mincrmatt12/MWatch/board/bigboard/bom.ods

Source: | /home/matthew/MWatch/board/bigboard/bigboard.kicad_sch
Date: | Thu 16 Jun 2022 10:04:57 PM
Tool: | Eeschema 6.0.5-a6ca702e91~116~ubuntu20.04.1
Generator: | /usr/share/kicad/plugins/bom_csv_grouped_by_value.py
Component Count: | 143
Item | Qty | Reference(s) | Value | LibPart | Footprint | Description | MPN | Type | Notes
1 | 2 | AE1, AE2 | Antenna_Loop | Device:Antenna_Loop | TerminalBlock_TE-Connectivity:TerminalBlock_TE_282834-2_1x02_P2.54mm_Horizontal | TERM BLK 2P SIDE ENT 2.54MM |  | DNP (TH)
2 | 1 | BT1 | Battery_Cell | Device:Battery_Cell | Connector_JST:JST_PH_B3B-PH-K_1x03_P2.00mm_Vertical | CONN HEADER VERT 3POS 2MM | B3B-PH-K-S(LF)(SN) | DNP (TH)
3 | 2 | C1, C4 | 470nF | Device:C | Capacitor_SMD:C_0402_1005Metric | CAP CERM 470nF +/- 10% 50V X5R 0402 |  | SMD
4 | 1 | C2 | 0.082uF | Device:C | Capacitor_SMD:C_0402_1005Metric | CAP CERM 0.082uF +/- 10% 50V X7R 0402 |  | SMD
5 | 1 | C3 | 0.22uF | Device:C | Capacitor_SMD:C_0402_1005Metric | CAP CERM 0.22uF +/- 10% 50V X7R 0402 |  | SMD
6 | 1 | C5 | 360pF | Device:C | Capacitor_SMD:C_0402_1005Metric | CAP CERM 360pF +/- 5% 50V C0G/NP0 0402 |  | SMD
7 | 2 | C6, C7 | 0.068uF | Device:C | Capacitor_SMD:C_0402_1005Metric | CAP CERM 0.068uF +/- 10% 25V X7R 0402 |  | SMD
8 | 1 | C8 | 2700pF | Device:C | Capacitor_SMD:C_0402_1005Metric | CAP CERM 2700pF +/- 10% 50V X7R 0402 |  | SMD
9 | 2 | C9, C10 | 15nF | Device:C | Capacitor_SMD:C_0402_1005Metric | CAP CERM 15nF +/- 10% 25V X7R 0402 |  | SMD
10 | 28 | C11, C13, C18, C20, C22, C23, C24, C27, C32, C35, C36, C38, C39, C40, C41, C42, C43, C44, C45, C48, C49, C50, C51, C52, C54, C55, C58, C59 | 100nF | Device:C | Capacitor_SMD:C_0201_0603Metric | CAP CERM 100nF +/- 10% 25V X5R 0201 |  | SMD
11 | 10 | C12, C14, C17, C19, C21, C28, C37, C46, C47, C53 | 1uF | Device:C | Capacitor_SMD:C_0201_0603Metric | CAP CERM 1uF +/- 10% 25V X5R 0201 |  | SMD
12 | 7 | C15, C16, C25, C26, C29, C30, C31 | 10uF | Device:C | Capacitor_SMD:C_0603_1608Metric | CAP CERM 10uF +/10% 25V X5R 0603 |  | SMD
13 | 2 | C33, C34 | 27pF | Device:C | Capacitor_SMD:C_0201_0603Metric | CAP CERM 27pF +/- 5% 50V C0G/NP0 0201 |  | SMD
14 | 2 | C56, C57 | 120pF | Device:C | Capacitor_SMD:C_0201_0603Metric | CAP CERM 120pF +/- 5% 50V C0G/NP0 0201 |  | SMD
15 | 1 | D1 | SP0502BAHTG | Power_Protection:SP0502BAHT | Package_TO_SOT_SMD:SOT-23 | DIODE TVS 5.5VWM 8.5VC SOT23-3 | SP0502BAHTG | SMD | or equivalent
16 | 4 | D2, D3, D7, D8 | D | Device:D | Diode_SMD:D_SOD-323 | DIODE SCHOTTKY 30V 1A USC | CUS10S30,H3F | SMD
17 | 3 | D4, D5, D6 | LED | Device:LED | LED_SMD:LED_0603_1608Metric | LED WHITE CLEAR CHIP SMD 5mA 3.2V 0603 | BZ-C0603-C2-E1 | SMD
18 | 2 | J1, J2 | Conn_02x02_Row_Letter_First | Connector_Generic:Conn_02x02_Odd_Even | Connector_PinHeader_2.54mm:PinHeader_2x02_P2.54mm_Vertical | CONN HEADER VERT 2x02POS 2.54MM |  | DNP (TH)
19 | 1 | J3 | USB_C_Receptacle_USB2.0 | Connector:USB_C_Receptacle_USB2.0 | Connector_USB:USB_C_Receptacle_XKB_U262-16XN-4BVC11 | CONN RCP USB3.1 TYPEC SMD RA | U262-161N-4BVC11 | SMD
20 | 5 | J4, J5, J6, J7, J12 | Conn_01x03_Male | Connector:Conn_01x03_Male | Connector_PinHeader_2.54mm:PinHeader_1x03_P2.54mm_Vertical | CONN HEADER VERT 3POS 2.54MM |  | DNP (TH)
21 | 1 | J8 | Conn_2Rows-21Pins_MountingPin | Connector_Generic_MountingPin:Conn_2Rows-21Pins_MountingPin | displaymolex:5035662102 | CONN FPC BOTTOM 21POS 0.30MM | 503566-2102 | SMD
22 | 1 | J9 | Conn_01x05_Male | Connector:Conn_01x05_Male | Connector_PinHeader_2.54mm:PinHeader_1x05_P2.54mm_Vertical | CONN HEADER VERT 5POS 2.54MM |  | DNP (TH)
23 | 1 | J10 | Conn_02x03_Row_Letter_First | Connector_Generic:Conn_02x03_Odd_Even | Connector_PinHeader_2.54mm:PinHeader_2x03_P2.54mm_Vertical | CONN HEADER VERT 2x03POS 2.54MM |  | DNP (TH)
24 | 1 | J11 | Conn_01x02_Male | Connector:Conn_01x02_Male | Connector_PinHeader_2.54mm:PinHeader_1x02_P2.54mm_Vertical | CONN HEADER VERT 2POS 2.54MM |  | DNP (TH)
25 | 1 | J13 | Conn_02x07_Row_Letter_First | Connector_Generic:Conn_02x07_Odd_Even | Connector_PinHeader_2.54mm:PinHeader_2x07_P2.54mm_Vertical | CONN HEADER VERT 2x07POS 2.54MM |  | DNP (TH)
26 | 1 | L1 | 4.7uH | Device:L | Inductor_SMD:L_0805_2012Metric | INDUCTOR 4.7uH +/- 20% 600mA 400 mOHM 0805 | MLP2012V4R7MT0S1 | SMD | or equivalent
27 | 2 | L2, L3 | 2.2uH | Device:L | Inductor_SMD:L_0805_2012Metric | INDUCTOR 2.2uH +/- 20% 1.2A 228 mOHM 0805 | DFE201210U-2R2M=P2 | SMD | or equivalent
28 | 1 | M1 | Motor_AC | Motor:Motor_AC | TerminalBlock_TE-Connectivity:TerminalBlock_TE_282834-2_1x02_P2.54mm_Horizontal | TERM BLK 2P SIDE ENT 2.54MM |  | DNP (TH)
29 | 1 | Q1 | Q_Dual_PMOS_G1S2G2D2S1D1 | Device:Q_Dual_PMOS_G1S2G2D2S1D1 | Package_TO_SOT_SMD:SOT-23-6 | MOSFET 2P-CH 20V 2A SOT-26 | DMP2240UDM | SMD
30 | 9 | R1, R2, R3, R22, R23, R24, R25, R26, R27 | 10k | Device:R_US | Resistor_SMD:R_0201_0603Metric | RES SMD 10KOHM 1% 1/20W 0201 |  | SMD
31 | 2 | R4, R5 | 5.1k | Device:R_US | Resistor_SMD:R_0201_0603Metric | RES SMD 5.1KOHM 1% 1/20W 0201 |  | SMD
32 | 2 | R6, R8 | 102k | Device:R_US | Resistor_SMD:R_0201_0603Metric | RES SMD 102KOHM 1% 1/20W 0201 |  | SMD
33 | 2 | R7, R9 | 11.3k | Device:R_US | Resistor_SMD:R_0201_0603Metric | RES SMD 11.3KOHM 1% 1/20W 0201 |  | SMD
34 | 1 | R10 | 150 | Device:R_US | Resistor_SMD:R_0201_0603Metric | RES SMD 150OHM 1% 1/20W 0201 |  | SMD
35 | 1 | R11 | 2.2k | Device:R_US | Resistor_SMD:R_0201_0603Metric | RES SMD 2.2KOHM 1% 1/20W 0201 |  | SMD
36 | 1 | R12 | 3.3k | Device:R_US | Resistor_SMD:R_0201_0603Metric | RES SMD 3.3KOHM 1% 1/20W 0201 |  | SMD
37 | 1 | R13 | 470 | Device:R_US | Resistor_SMD:R_0201_0603Metric | RES SMD 470OHM 1% 1/20W 0201 |  | SMD
38 | 1 | R14 | 22 | Device:R_US | Resistor_SMD:R_0201_0603Metric | RES SMD 22OHM 1% 1/20W 0201 |  | SMD
39 | 1 | R15 | 20k | Device:R_US | Resistor_SMD:R_0201_0603Metric | RES SMD 20KOHM 1% 1/20W 0201 |  | SMD
40 | 1 | R16 | 1M | Device:R_US | Resistor_SMD:R_0201_0603Metric | RES SMD 1M0OHM 1% 1/20W 0201 |  | SMD
41 | 1 | R17 | 4k | Device:R_US | Resistor_SMD:R_0201_0603Metric | RES SMD 4KOHM 1% 1/20W 0201 |  | SMD
42 | 2 | R18, R19 | 1k | Device:R_US | Resistor_SMD:R_0201_0603Metric | RES SMD 1KOHM 1% 1/20W 0201 |  | SMD
43 | 2 | R20, R21 | 27 | Device:R_US | Resistor_SMD:R_0201_0603Metric | RES SMD 27OHM 1% 1/20W 0201 |  | SMD
44 | 8 | SW1, SW2, SW3, SW4, SW5, SW6, SW7, SW8 | SW_Push | Switch:SW_Push | Button_Switch_THT:SW_PUSH_6mm | SWITCH TACTILE SPST-NO 0.05A 24V | B3F-1020 | DNP (TH)
45 | 1 | TH1 | NTCG103JF103FT1 | Device:Thermistor_NTC_US | Resistor_SMD:R_0402_1005Metric | THERMISTOR NTC 10KOHM 3380K 0402 | NTCG103JF103FT1 | SMD | or equivalent
46 | 5 | TP1, TP2, TP3, TP4, TP5 | TestPoint | Connector:TestPoint | TestPoint:TestPoint_Pad_D2.5mm |  |  | n/a
47 | 1 | U1 | BQ51221YFPT | bq51020:BQ51221YFPT | bq51020:BQ51221YFPT | IC WIRELESS PWR RCVR 42DSBGA | BQ51221YFPT | SMD
48 | 1 | U2 | MAX20353AEWN+ | max20353:MAX20353AEWN+ | max20353:MAX20353AEWN&plus_ | IC WEARABLE PMIC | MAX20353AEWN+ | SMD
49 | 1 | U3 | D52MxxM8 | RF_Module:D52MxxM8 | RF_Module:Garmin_M8-35_9.8x14.0mm_Layout6x6_P1.5mm | BLUETOOTH MOD ISM>1GHZ TRC ANT SMD | D52MD2M8IA-TRAY | SMD
50 | 1 | U4 | RP2040 | rp2040:RP2040 | rp2040:RP2040-QFN-56 | IC RP2040 DUAL CORE MCU 56-QFN | SC0914(7) | SMD | also known as RP2040 at LCSC
51 | 2 | U5, U6 | SN74LVC8T245PWR | Logic_LevelTranslator:SN74AVC8T245PW | Package_SO:TSSOP-24_4.4x7.8mm_P0.65mm | IC 8-BIT DUAL-SUPPLY BUS TRANSCEIVER | SN74LVC8T245PWR | SMD | acceptable substitute is SN74LXC8T245PWR, SN74LVCH8T245PWR; -PW and -PWR parts are interchangable
52 | 1 | U7 | GD25LQ128DSIGR | Memory_Flash:W25Q128JVS | Package_SO:SOIC-8_5.23x5.23mm_P1.27mm | IC FLASH 128MBIT SPI/QUAD 8SOP 1.8V | GD25LQ128DSIGR | SMD | acceptable substitute is W25Q128JWS
53 | 1 | U8 | BMM150 | Sensor_Magnetic:BMM150 | Package_CSP:WLCSP-12_1.56x1.56mm_P0.4mm | SENSOR FLIPCORE/HALL I2C/SPI 12WLCSP | BMM150 | SMD
54 | 1 | U9 | BMI270 | Sensor_Motion:BMI160 | Package_LGA:Bosch_LGA-14_3x2.5mm_P0.5mm | SENSOR IMU ACCEL/GYRO I2C/SPI 14LGA | BMI270 | SMD
55 | 1 | U10 | APDS-9306-065 | Sensor_Optical:APDS-9306-065 | OptoDevice:Broadcom_DFN-6_2x2mm_P0.65mm | SENSOR AMBIENT LIGHT 6-DFN | APDS-9306-065 | SMD
56 | 1 | U11 | TXB0104D | Logic_LevelTranslator:TXB0104D | Package_SO:SOIC-14_3.9x8.7mm_P1.27mm | IC TRNSLTR BIDIRECTIONAL 14SOIC | TXB0104D | SMD
57 | 1 | U12 | PCF85263AT/AJ | Timer_RTC:PCF85263AT | Package_SO:SOIC-8_3.9x4.9mm_P1.27mm | IC RTC CLK/CALENDAR I2C 8SO | PCF85263AT/AJ | SMD | acceptable substitute is BQ32002DR
58 | 1 | Y1 | 12MHz | Device:Crystal | Crystal:Crystal_SMD_5032-2Pin_5.0x3.2mm | CRYSTAL 12.0000MHZ 18pF 50OHM 20 PPM SMD | 445C25D12M00000 | SMD | or equivalent
59 | 1 | Y2 | 32.768kHz | Device:Crystal | Crystal:Crystal_SMD_3215-2Pin_3.2x1.5mm | CRYSTAL 32.768KHZ 7pF 70KOHM 20 PPM SMD | SC32S-7PF20PPM | SMD | or equivalent
