mincrmatt12/MWatch/board/bigboard/bigboard.pdf

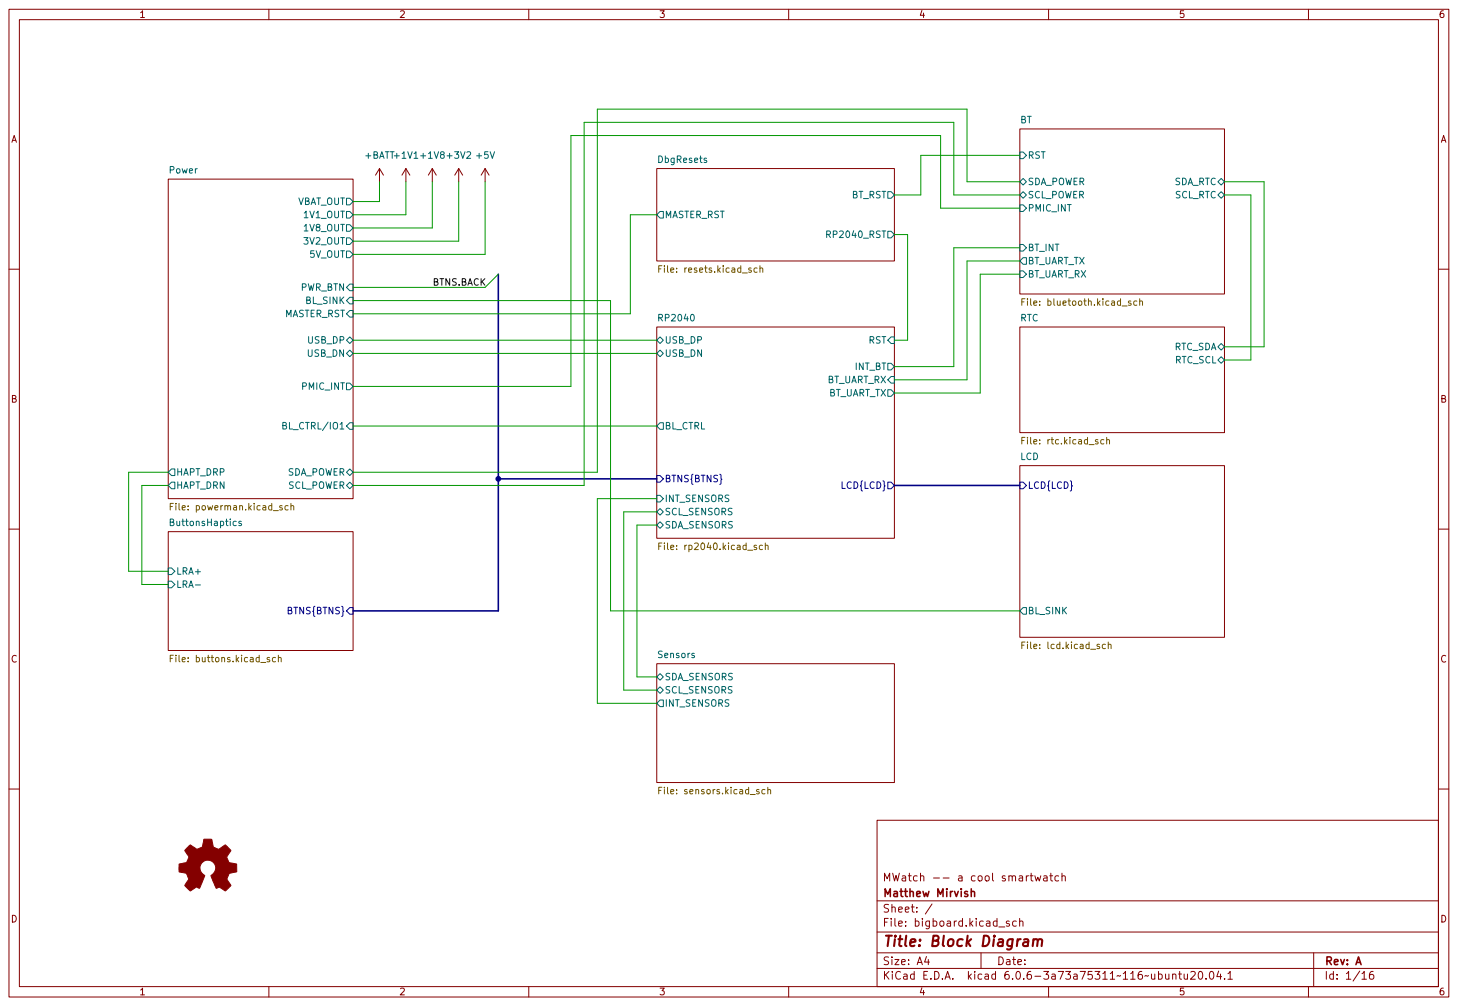
[picture p1: page 1]

File: lcd.kicad_sch BTNS{BTNS} LRA+

File: bigboard.kicad_sch Sheet: / Matthew Mirvish MWatch -- a cool smartwatch

Id: 1/16 Title: Block Diagram

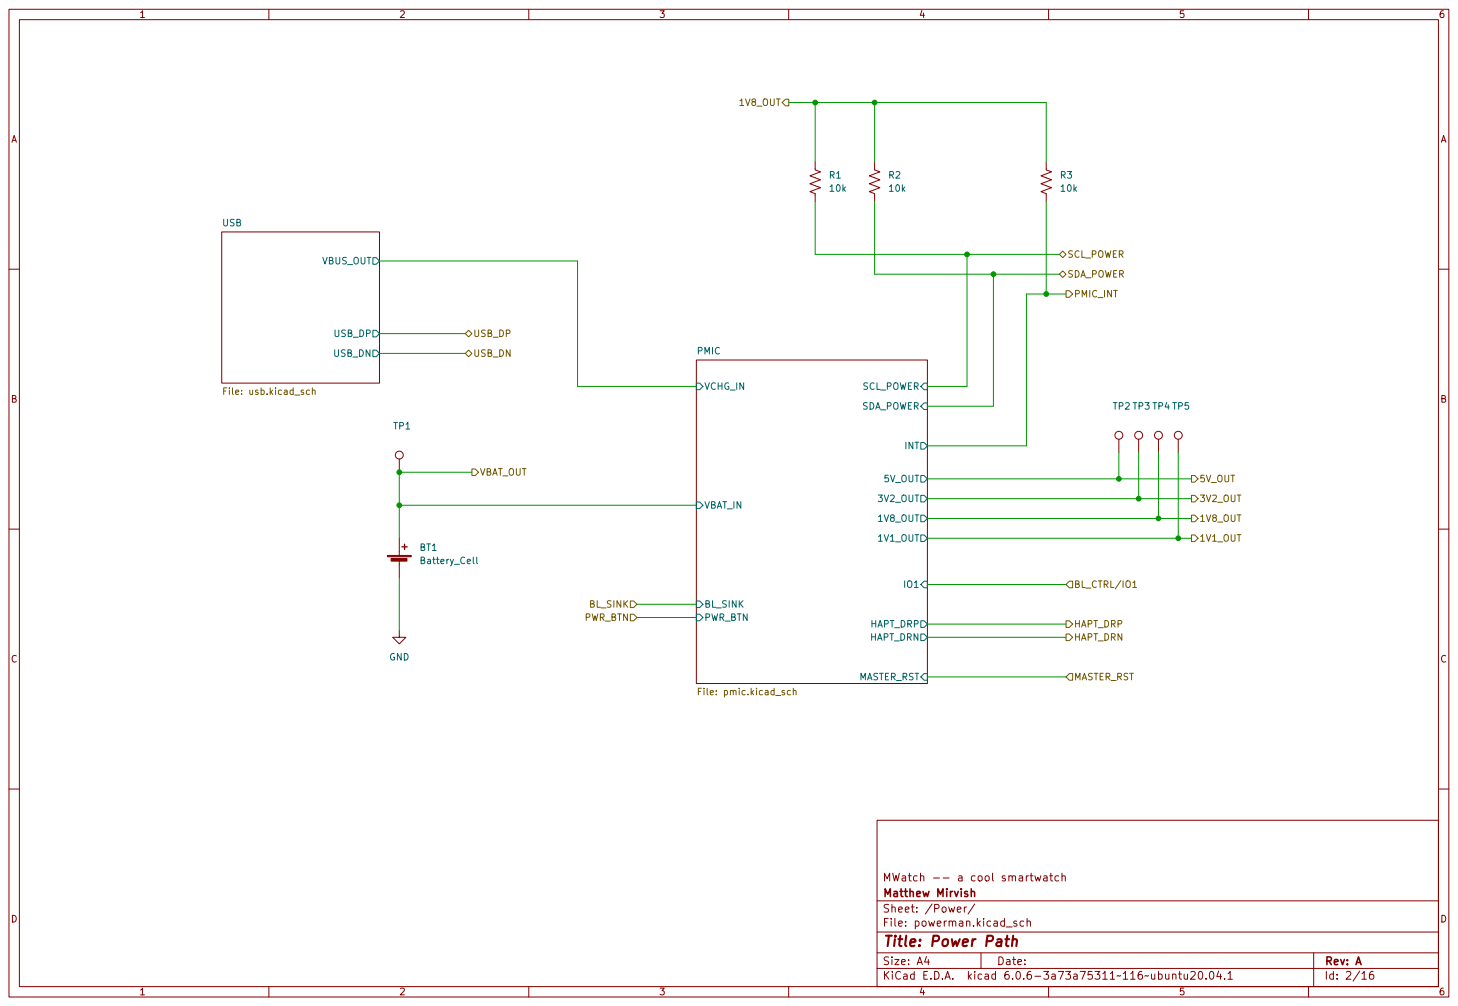
[picture p2: page 2]

File: powerman.kicad_sch Sheet: /Power/ Matthew Mirvish MWatch -- a cool smartwatch

Id: 2/16 Title: Power Path

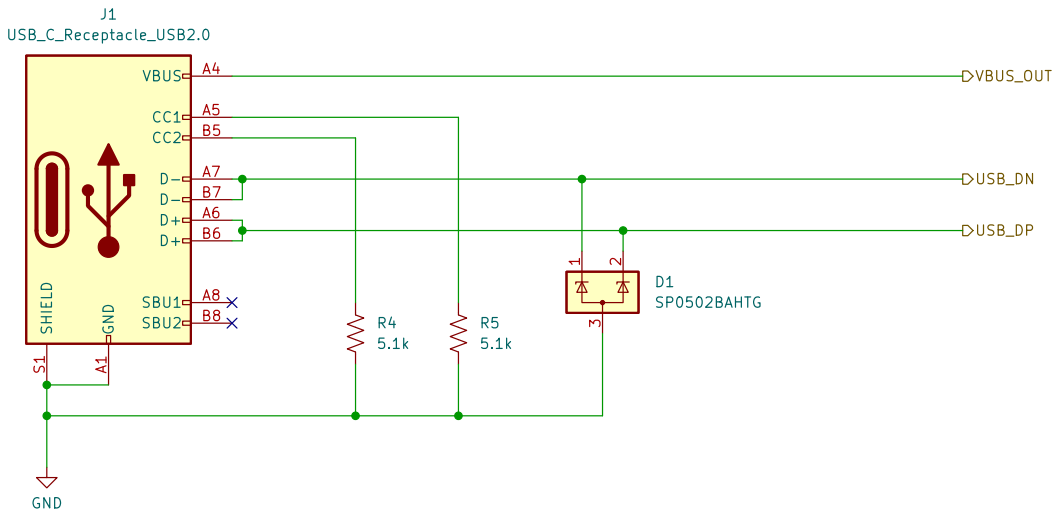
[picture p3: page 3]

File: usb.kicad_sch Sheet: /Power/USB/ Matthew Mirvish MWatch -- a cool smartwatch

Id: 3/16 Title: USB Port

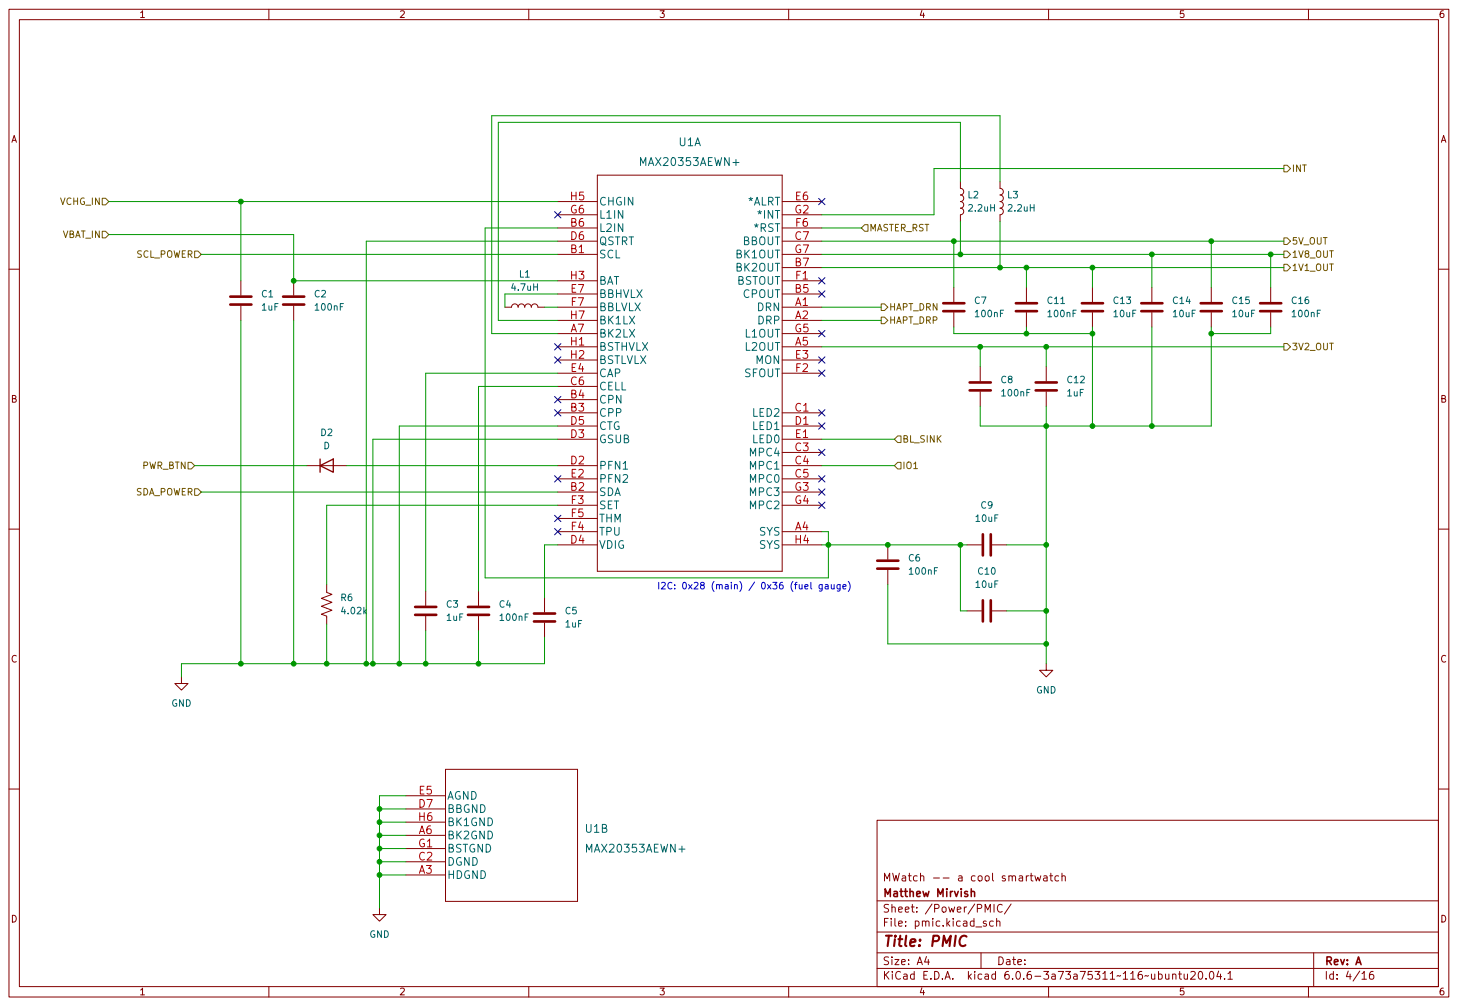
[picture p4: page 4]

File: pmic.kicad_sch Sheet: /Power/PMIC/ Matthew Mirvish MWatch -- a cool smartwatch C6

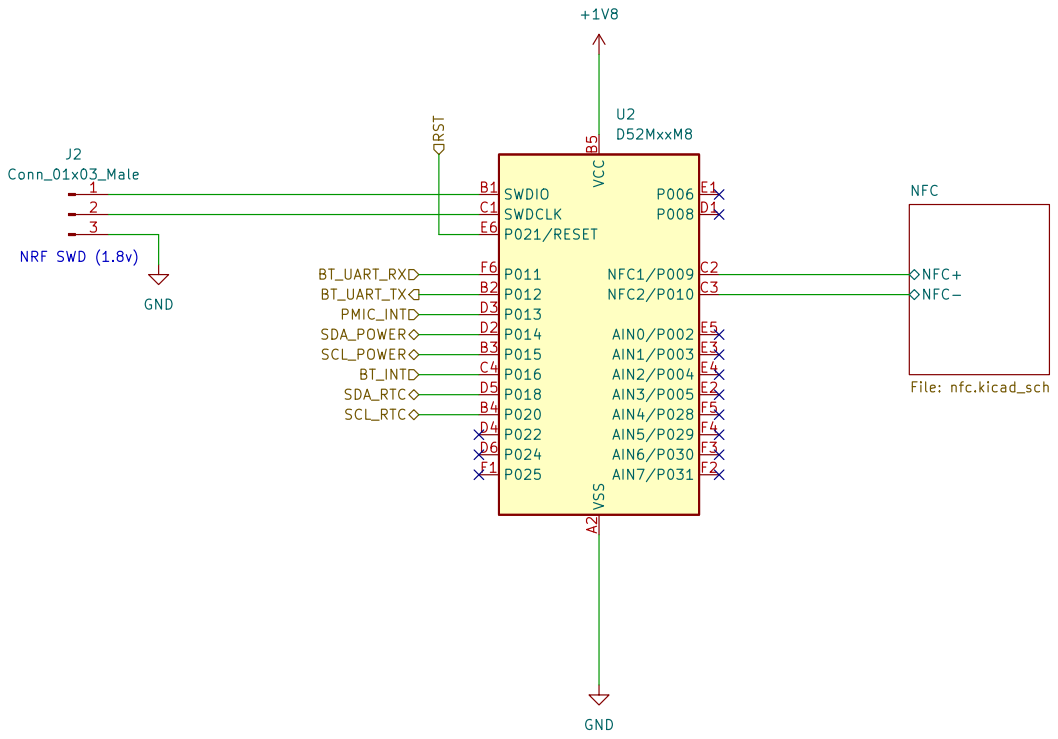
[picture p5: page 5]

File: bluetooth.kicad_sch Sheet: /BT/ Matthew Mirvish MWatch -- a cool smartwatch NFC+ NFC- NFC

Id: 5/16 Title: Bluetooth Controller

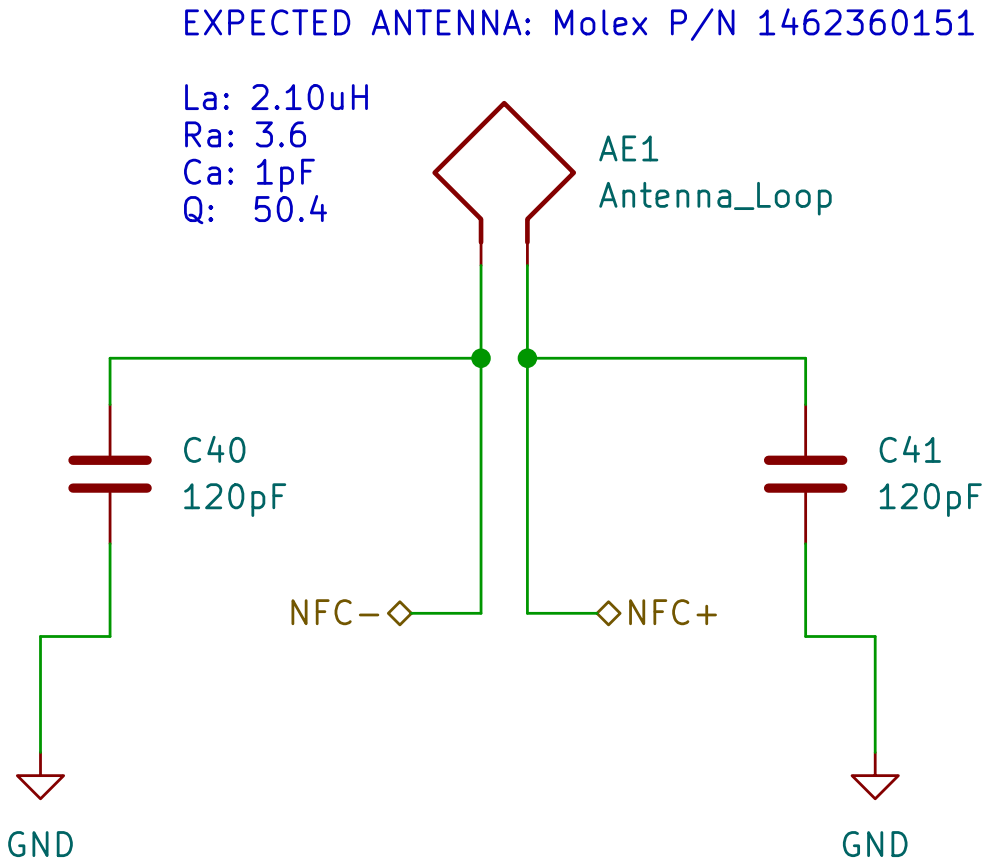
[picture p6: page 6]

File: nfc.kicad_sch Sheet: /BT/NFC/ Matthew Mirvish MWatch -- a cool smartwatch GND

Id: 6/16 Title: NFC Antenna

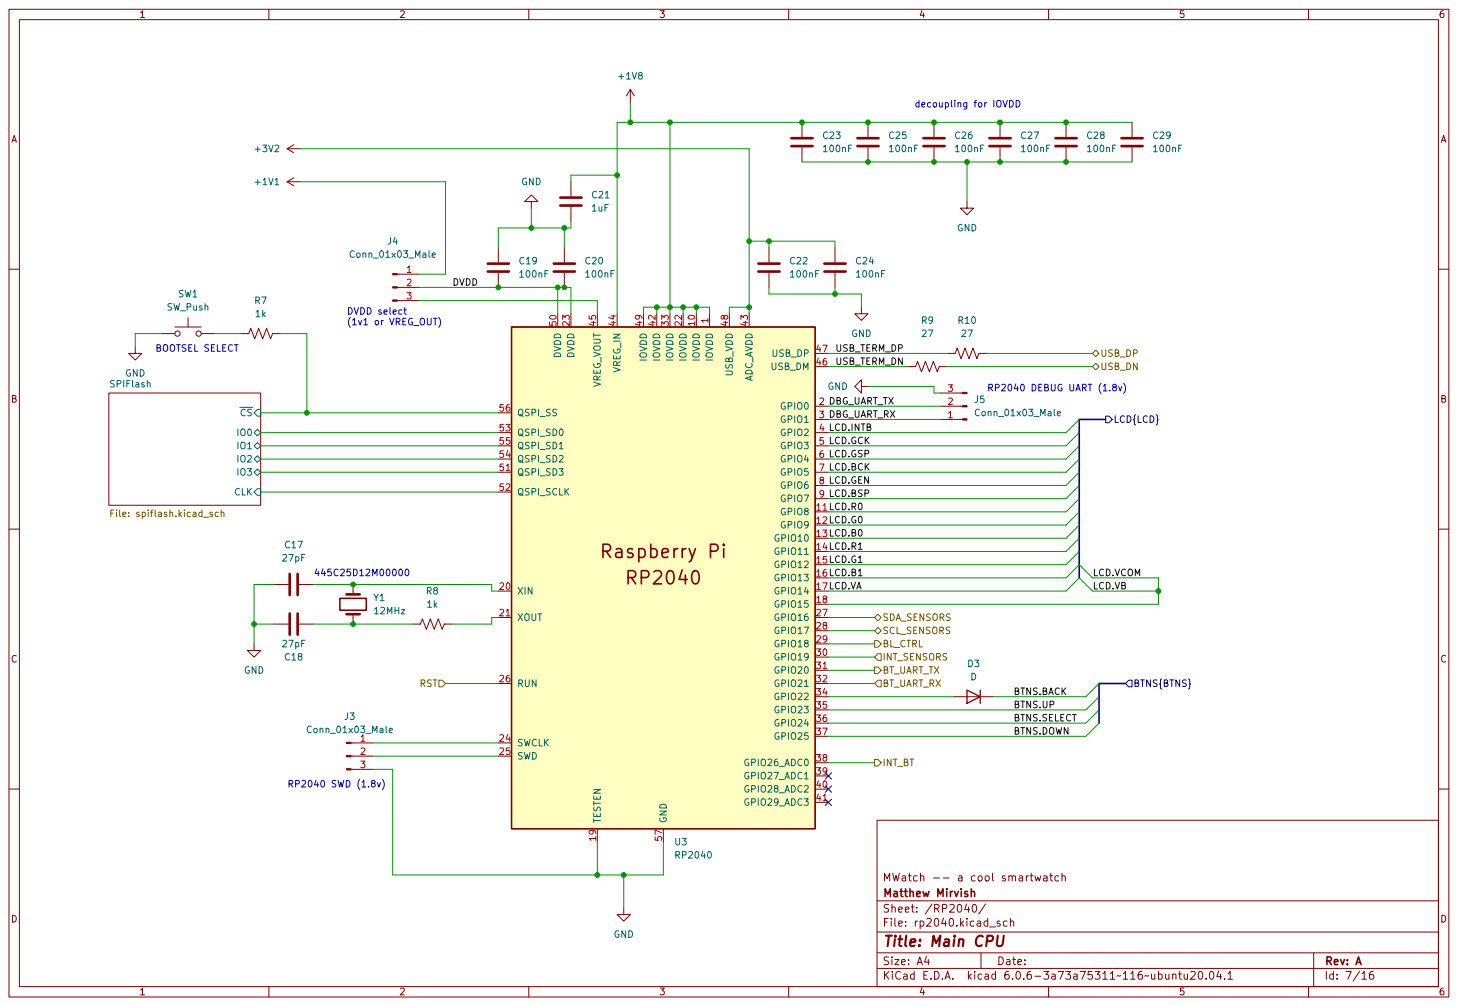
[picture p7: page 7]

RP2040 DEBUG UART (1.8v) DVDD select (1v1 or VREG_OUT) BOOTSEL SELECT

1 IOVDD 10 GPIO8 11 GPIO9 12 GPIO10 13 GPIO11 14 GPIO12 15 GPIO13 16 GPIO14 17 GPIO15 18 TESTEN 19 GPIO0 2 XIN 20 XOUT 21 IOVDD 22 DVDD 23 SWCLK 24 SWD 25 RUN 26 GPIO16 27 GPIO17 28 GPIO18 29 GPIO1 3 GPIO19 30 GPIO20 31 GPIO21 32 IOVDD 33 GPIO22 34 GPIO23 35 GPIO24 36 GPIO25 37 GPIO26_ADC0 38 GPIO27_ADC1 39 GPIO2 4 GPIO28_ADC2 40 GPIO29_ADC3 41 IOVDD 42 ADC_AVDD 43 VREG_IN 44 VREG_VOUT 45 USB_DM 46 USB_DP 47 USB_VDD 48 IOVDD 49 GPIO3 5 DVDD 50 QSPI_SD3 51 QSPI_SCLK 52 QSPI_SD0 53 QSPI_SD2 54 QSPI_SD1 55 QSPI_SS 56 GND 57 GPIO4 6 GPIO5 7 GPIO6 8 GPIO7 9 U3RP2040

BTNS.SELECT BTNS.UP

File: rp2040.kicad_sch Sheet: /RP2040/ Matthew Mirvish MWatch -- a cool smartwatch

Id: 7/16 Title: Main CPU

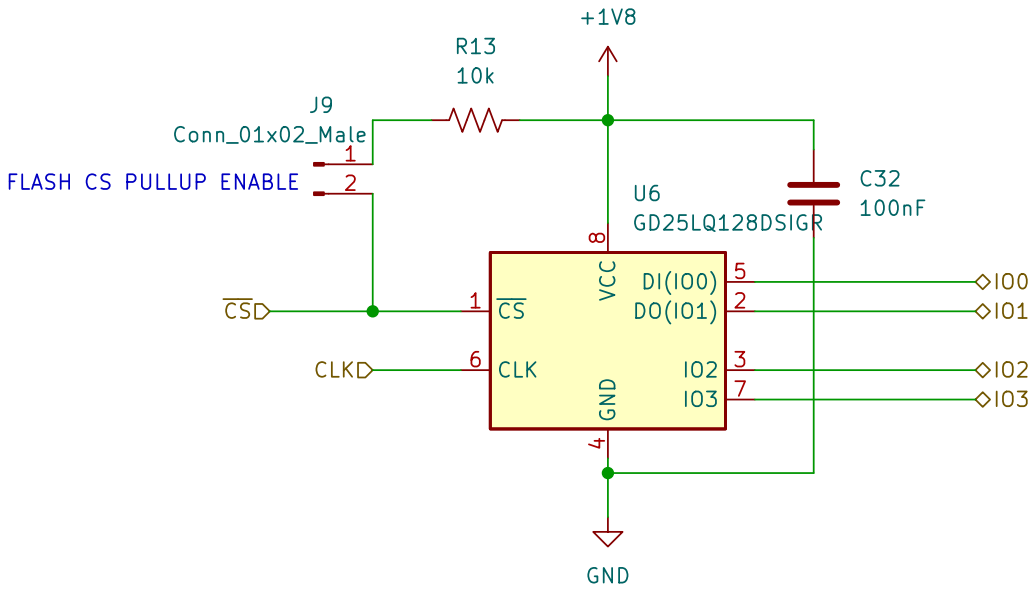
[picture p8: page 8]

~{CS} FLASH CS PULLUP ENABLE

File: spiflash.kicad_sch Sheet: /RP2040/SPIFlash/ Matthew Mirvish MWatch -- a cool smartwatch

Id: 8/16 Title: Main CPU SPI Flash

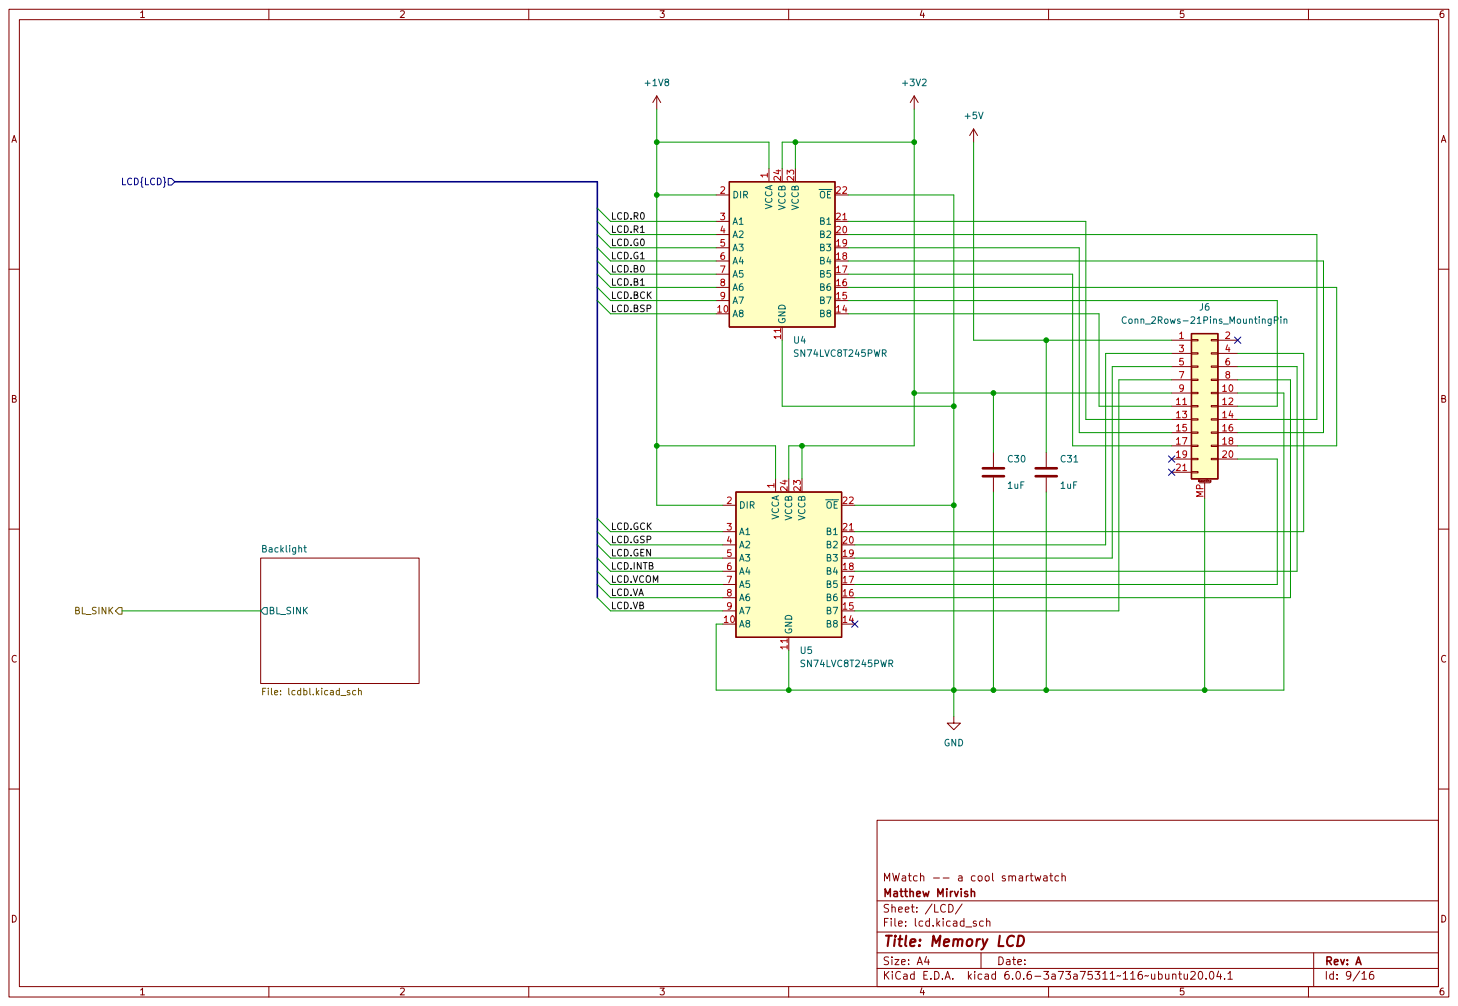
[picture p9: page 9]

1 A8 10 GND 11 B8 14 B7 15 B6 16 B5 17 B4 18 B3 19 DIR 2 B2 20 B1 21 ~{OE}22 VCCB 23 VCCB 24 A1 3 A2 4 A3 5 A4 6 A5 7 A6 8 A7 9 U4SN74LVC8T245PWR VCCA

5 | J6 Conn_2Rows-21Pins_MountingPin C31 | 6

Mounting 1 | 10

9 MP 15 | | 16

1 A8 10 GND 11 B8 14 B7 15 B6 16 B5 17 B4 18 B3 19 DIR 2 B2 20 B1 21 ~{OE}22 VCCB 23 VCCB 24 A1 3 A2 4 A3 5 A4 6 A5 7 A6 8 A7 9 U5SN74LVC8T245PWR

File: lcd.kicad_sch Sheet: /LCD/ Matthew Mirvish MWatch -- a cool smartwatch BL_SINK

Id: 9/16 Title: Memory LCD

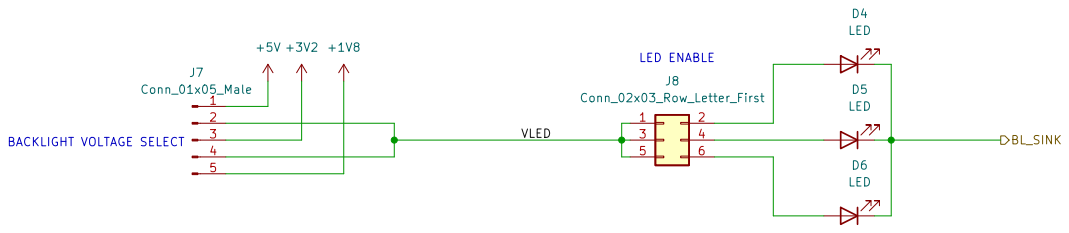
[picture p10: page 10]

Sheet: /LCD/Backlight/ Matthew Mirvish MWatch -- a cool smartwatch

File: lcdbl.kicad_sch
Id: 10/16 Title: LCD Backlight

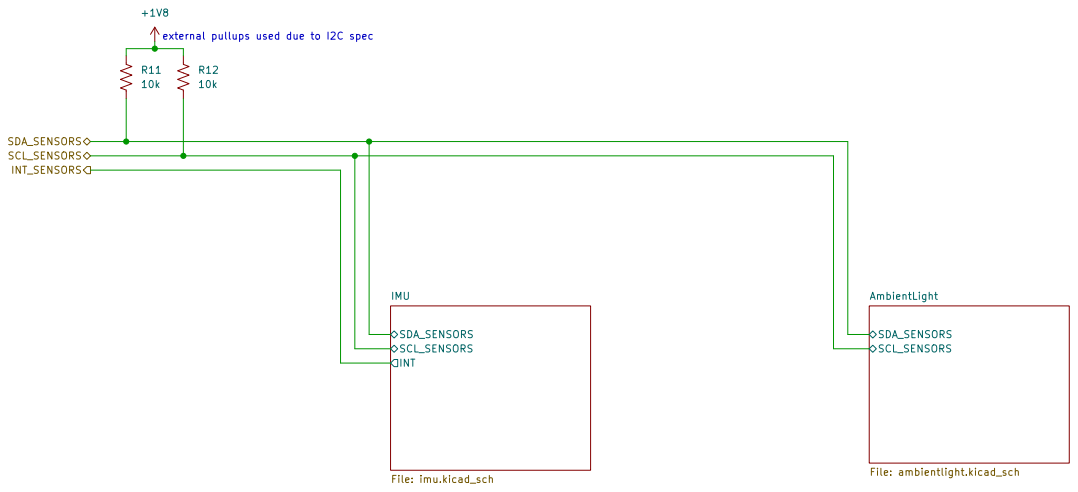
[picture p11: page 11]

external pullups used due to I2C spec

AmbientLight
File: sensors.kicad_sch Sheet: /Sensors/ Matthew Mirvish MWatch -- a cool smartwatch SCL_SENSORS

Id: 11/16 Title: Sensor Bus

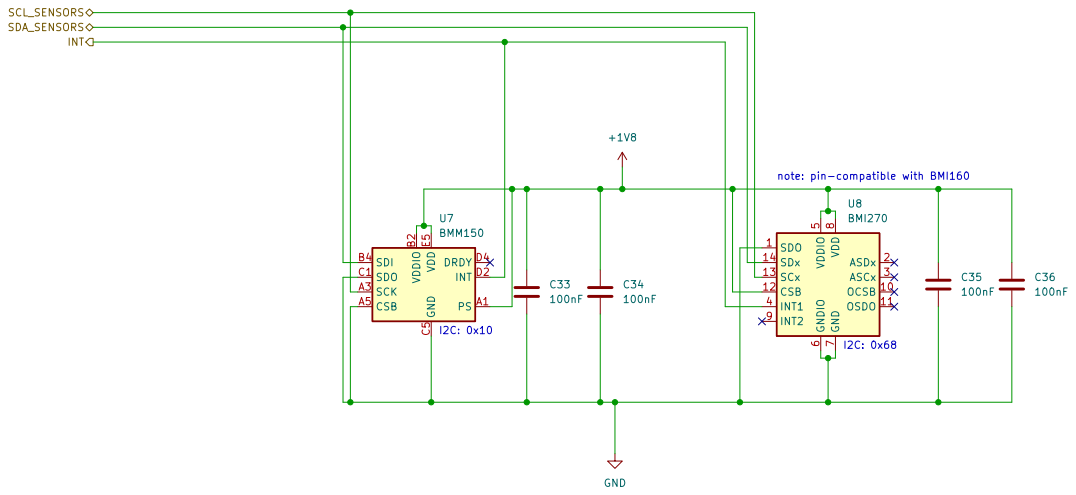
[picture p12: page 12]

note: pin-compatible with BMI160

File: imu.kicad_sch Sheet: /Sensors/IMU/ Matthew Mirvish MWatch -- a cool smartwatch

Id: 12/16 Title: IMU & Compass

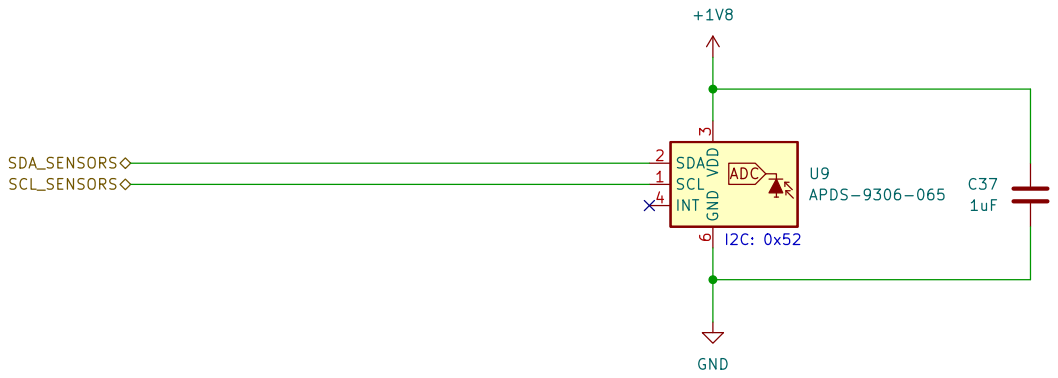
[picture p13: page 13]

Sheet: /Sensors/AmbientLight/ Matthew Mirvish MWatch -- a cool smartwatch

File: ambientlight.kicad_sch
Id: 13/16 Title: Ambient Light

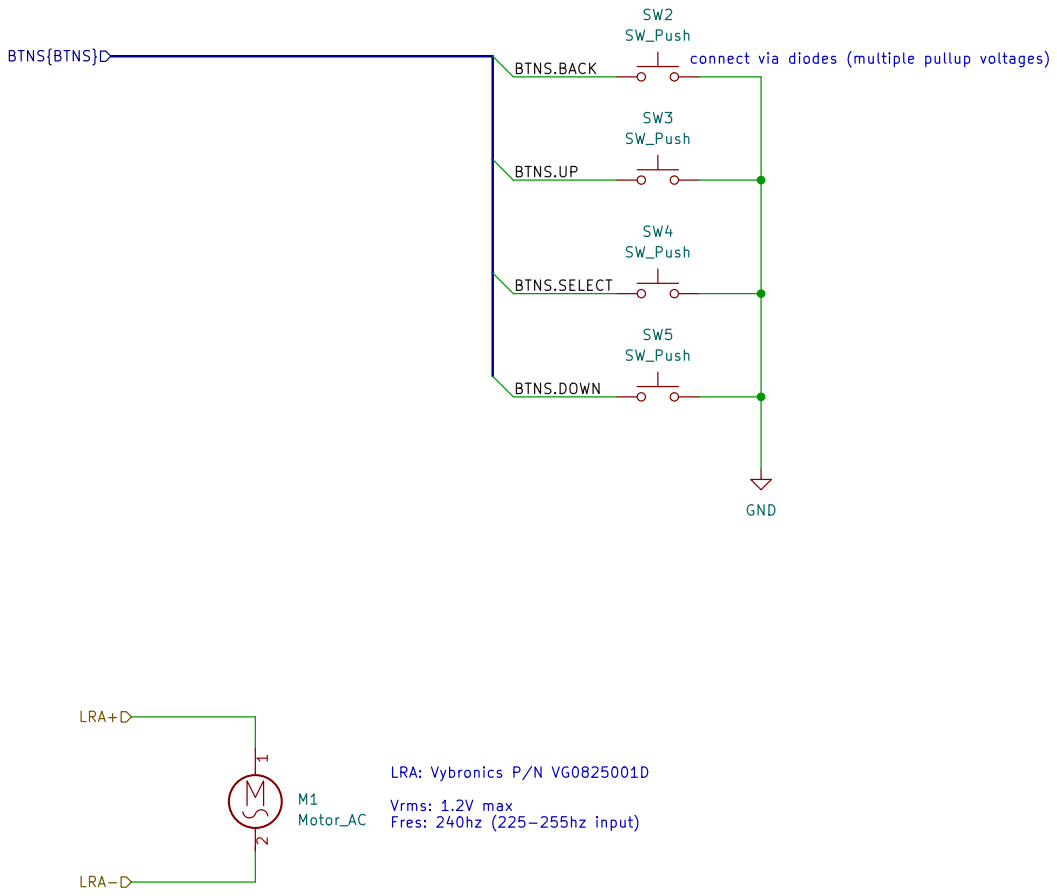
[picture p14: page 14]

Sheet: /ButtonsHaptics/ Matthew Mirvish MWatch -- a cool smartwatch GND

Vrms: 1.2V max Fres: 240hz (225-255hz input)

File: buttons.kicad_sch
Id: 14/16 Title: Buttons & Haptics

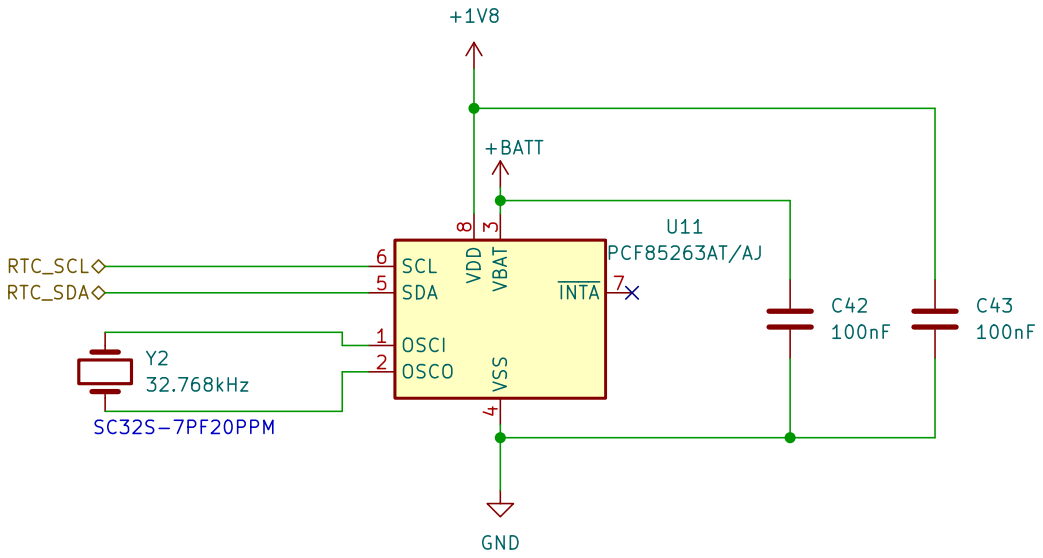
[picture p15: page 15]

4 SDA 5 SCL 6 ~{INTA} VDD 7

File: rtc.kicad_sch Sheet: /RTC/ Y2

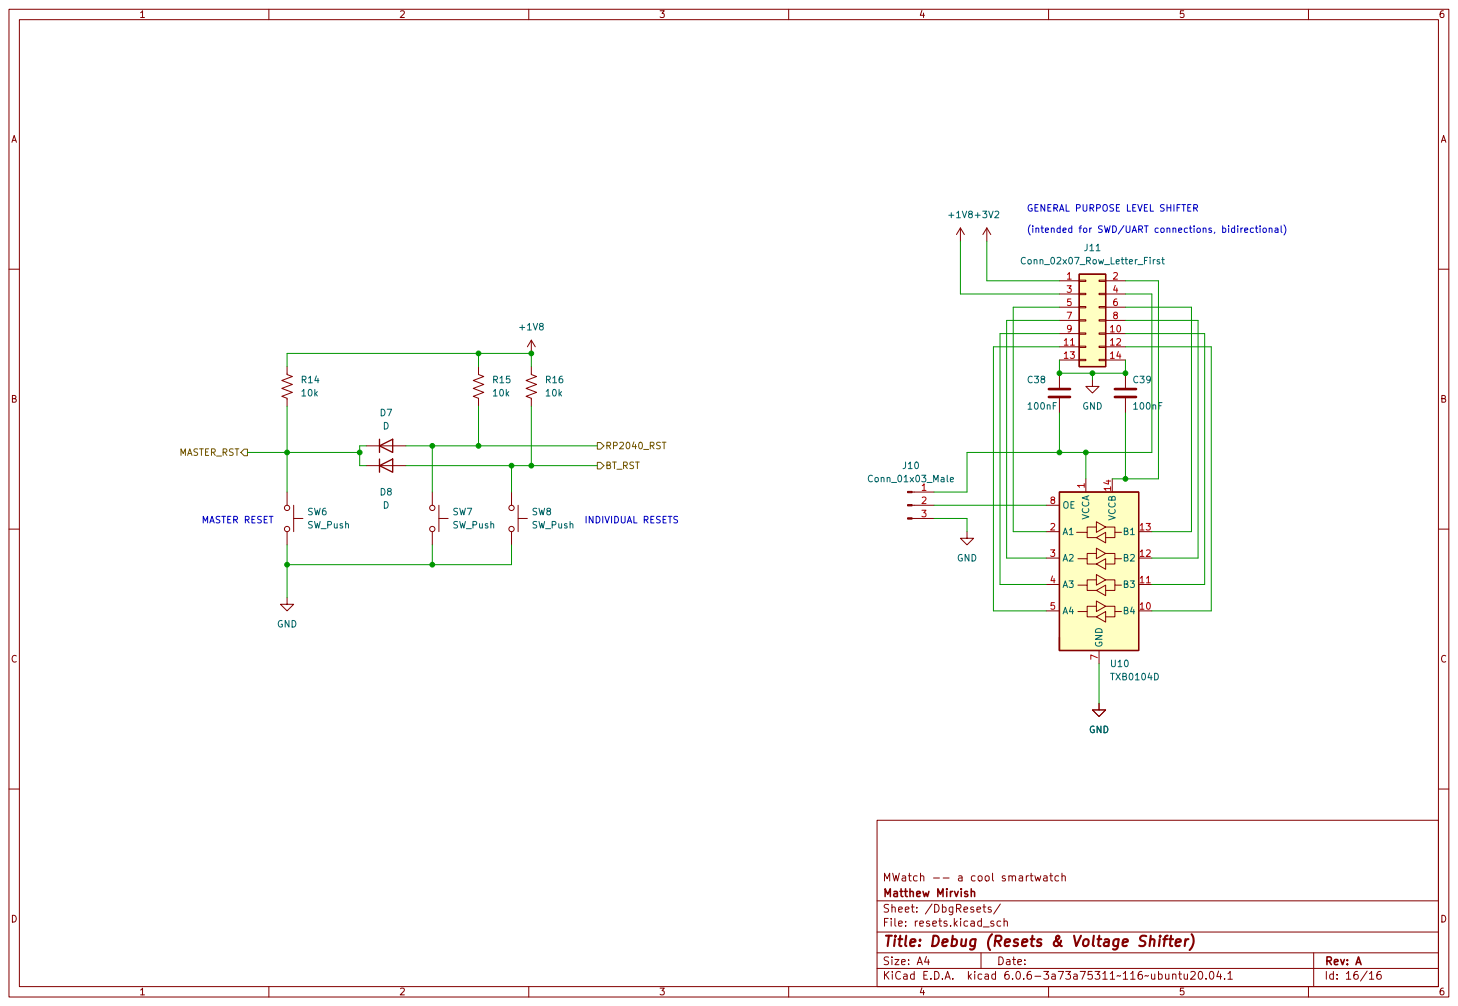
[picture p16: page 16]

(intended for SWD/UART connections, bidirectional) MASTER RESET

9 | 10
11 | 12
13 | 14

Sheet: /DbgResets/ Matthew Mirvish MWatch -- a cool smartwatch

File: resets.kicad_sch
Id: 16/16 Title: Debug (Resets & Voltage Shifter)
