mincrmatt12/MWatch/board/bigboard/bigboard.kicad_pcb

## KiCad design board/bigboard/bigboard.kicad_pcb (2023-10-31)

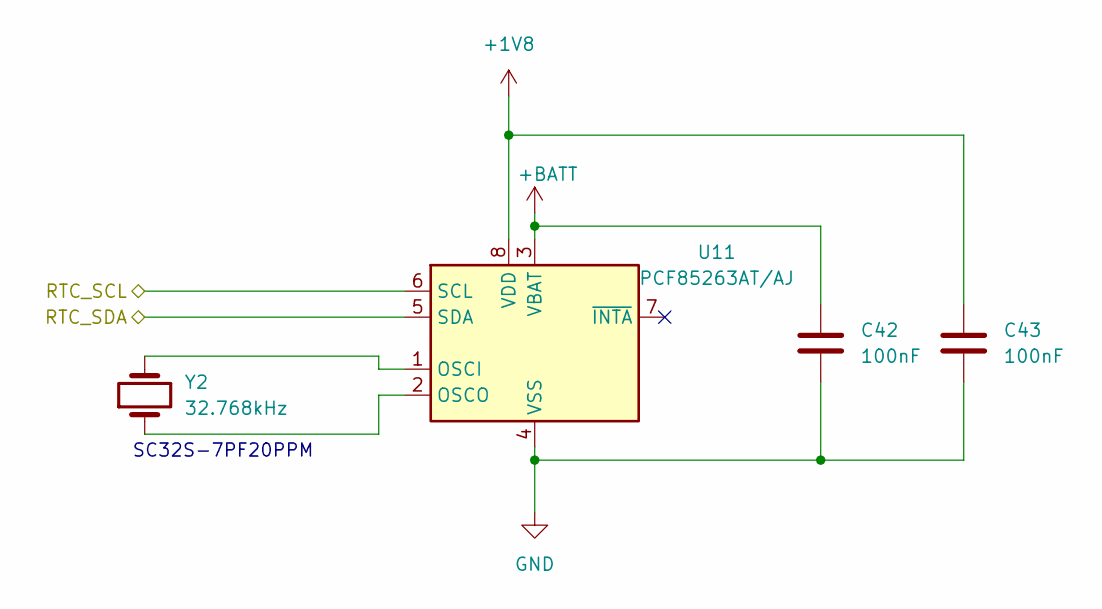
[picture p17: schematic rtc.kicad_sch]

Parts:
C42, C43: 100nF; C_0201_0603Metric; MPN CC0201KRX5R8BB104
U11: PCF85263AT/AJ; SOIC-8_3.9x4.9mm_P1.27mm; MPN PCF85263AT/AJ
Y2: 32.768kHz; Crystal_SMD_3215-2Pin_3.2x1.5mm; MPN SC32S-7PF20PPM

Connections:
+1V8: C43.1, U11.8 (VDD); also elsewhere on the board
+BATT: C42.1, U11.3 (VBAT); also elsewhere on the board
/BT/SCL_RTC: U11.6 (SCL); also elsewhere on the board
/BT/SDA_RTC: U11.5 (SDA); also elsewhere on the board
GND: C42.2, C43.2, U11.4 (VSS); also elsewhere on the board
unnamed: U11.1 (OSCI), Y2.2
unnamed: U11.2 (OSCO), Y2.1

Notes on the sheet:
SC32S-7PF20PPM

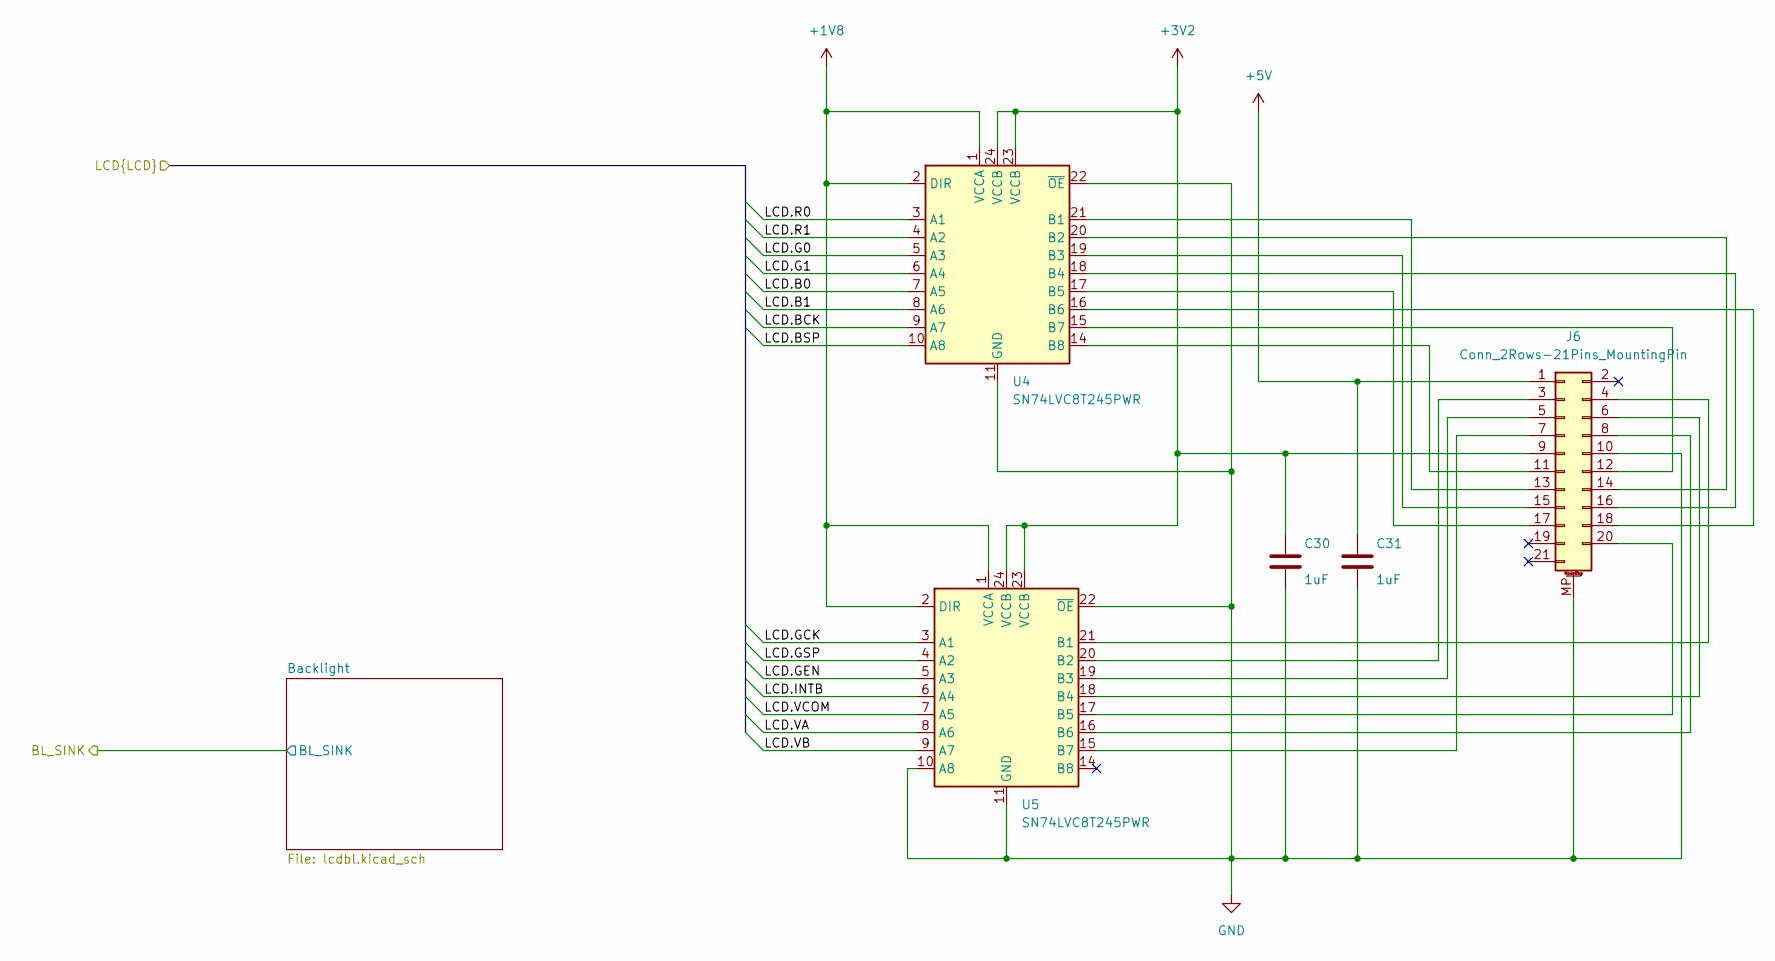
[picture p18: schematic lcd.kicad_sch, Memory LCD]

Parts:
C30, C31: 1uF; C_0201_0603Metric; MPN CC0201MRX5R6BB105
J6: Conn_2Rows-21Pins_MountingPin; 5035662102; MPN 503566-2102
U4, U5: SN74LVC8T245PWR; TSSOP-24_4.4x7.8mm_P0.65mm; MPN SN74LVC8T245PWR

Connections:
+1V8: U4.1 (VCCA), U4.2 (DIR), U5.1 (VCCA), U5.2 (DIR); also elsewhere on the board
+3V2: C30.1, J6.9, U4.23 (VCCB), U4.24 (VCCB), U5.23 (VCCB), U5.24 (VCCB); also elsewhere on the board
+5V: C31.1, J6.1; also elsewhere on the board
/LCD/LCD.B0: U4.7 (A5); also elsewhere on the board
/LCD/LCD.B1: U4.8 (A6); also elsewhere on the board
/LCD/LCD.BCK: U4.9 (A7); also elsewhere on the board
/LCD/LCD.BSP: U4.10 (A8); also elsewhere on the board
/LCD/LCD.G0: U4.5 (A3); also elsewhere on the board
/LCD/LCD.G1: U4.6 (A4); also elsewhere on the board
/LCD/LCD.GCK: U5.3 (A1); also elsewhere on the board
/LCD/LCD.GEN: U5.5 (A3); also elsewhere on the board
/LCD/LCD.GSP: U5.4 (A2); also elsewhere on the board
/LCD/LCD.INTB: U5.6 (A4); also elsewhere on the board
/LCD/LCD.R0: U4.3 (A1); also elsewhere on the board
/LCD/LCD.R1: U4.4 (A2); also elsewhere on the board
/LCD/LCD.VA: U5.8 (A6); also elsewhere on the board
/LCD/LCD.VB: U5.7 (A5), U5.9 (A7); also elsewhere on the board
GND: C30.2, C31.2, J6.10, J6.MP (MountPin), U4.11 (GND), U4.12 (GND), U4.13 (GND), U4.22 (~OE), U5.10 (A8), U5.11 (GND), U5.12 (GND), U5.13 (GND), U5.22 (~OE); also elsewhere on the board
unnamed: J6.3, U5.20 (B2)
unnamed: J6.4, U5.21 (B1)
unnamed: J6.5, U5.19 (B3)
unnamed: J6.6, U5.18 (B4)
unnamed: J6.7, U5.15 (B7)
unnamed: J6.8, U5.16 (B6)
unnamed: J6.11, U4.14 (B8)
unnamed: J6.12, U4.15 (B7)
unnamed: J6.13, U4.21 (B1)
unnamed: J6.14, U4.20 (B2)
unnamed: J6.15, U4.19 (B3)
unnamed: J6.16, U4.18 (B4)
unnamed: J6.17, U4.17 (B5)
unnamed: J6.18, U4.16 (B6)
unnamed: J6.20, U5.17 (B5)

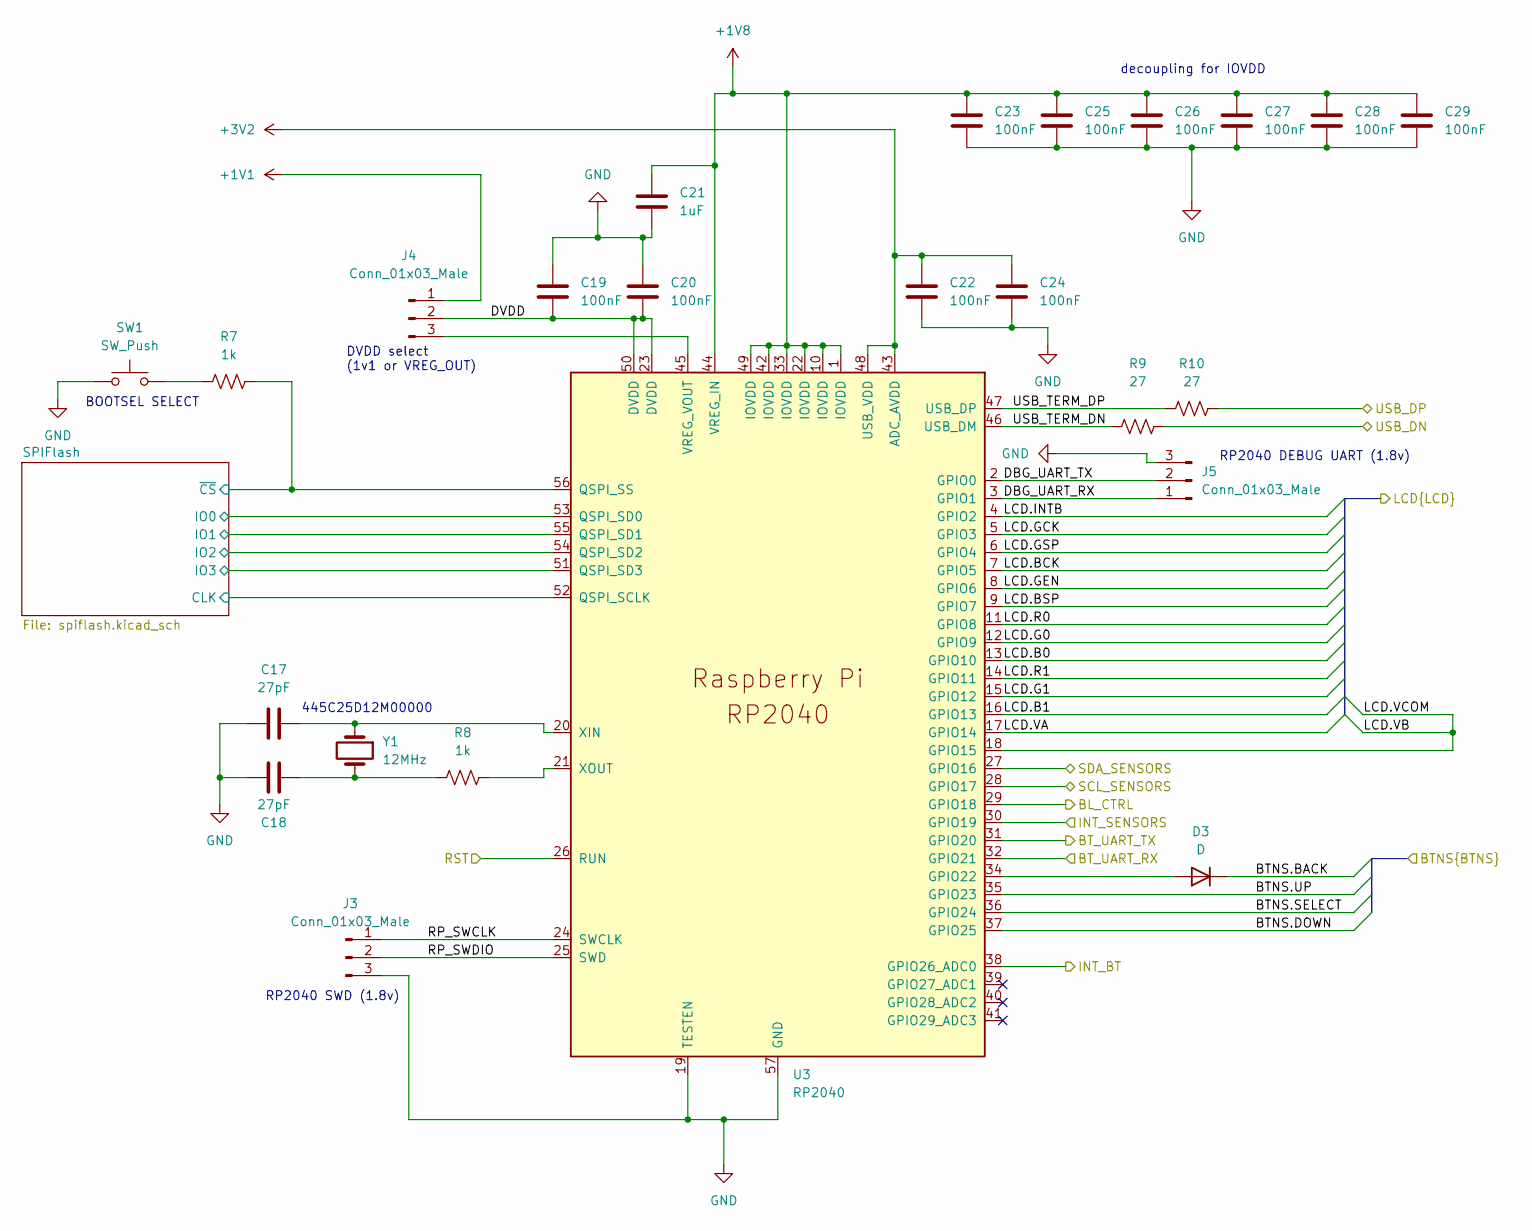
[picture p19: schematic rp2040.kicad_sch, Main CPU]

Parts:
C17, C18: 27pF; C_0201_0603Metric; MPN CC0201JRNPO9BN270
C19, C20, C22, C23, C24, C25, C26, C27, C28, C29: 100nF; C_0201_0603Metric; MPN CC0201KRX5R8BB104
C21: 1uF; C_0201_0603Metric; MPN CC0201MRX5R6BB105
D3: D; D_SOD-323; MPN CUS10S30,H3F
J3, J4, J5: Conn_01x03_Male; PinHeader_1x03_P2.54mm_Vertical
R7, R8: 1k; R_0201_0603Metric; MPN RC0201FR-071KL
R9, R10: 27; R_0201_0603Metric; MPN RC0201FR-0727RL
SW1: SW_Push; SW_PUSH_6mm; MPN B3F-1020
U3: RP2040; RP2040-QFN-56; MPN SC0914(7)
Y1: 12MHz; Crystal_SMD_5032-2Pin_5.0x3.2mm; MPN 445C25D12M00000

Connections:
+1V1: J4.1; also elsewhere on the board
+1V8: C21.1, C23.1, C25.1, C26.1, C27.1, C28.1, C29.1, U3.1 (IOVDD), U3.10 (IOVDD), U3.22 (IOVDD), U3.33 (IOVDD), U3.42 (IOVDD), U3.44 (VREG_IN), U3.49 (IOVDD); also elsewhere on the board
+3V2: C22.1, C24.1, U3.43 (ADC_AVDD), U3.48 (USB_VDD); also elsewhere on the board
/BT/BT_INT: U3.38 (GPIO26_ADC0); also elsewhere on the board
/BT/BT_UART_RX: U3.31 (GPIO20); also elsewhere on the board
/BT/BT_UART_TX: U3.32 (GPIO21); also elsewhere on the board
/ButtonsHaptics/BTNS.BACK: D3.1 (K); also elsewhere on the board
/ButtonsHaptics/BTNS.DOWN: U3.37 (GPIO25); also elsewhere on the board
/ButtonsHaptics/BTNS.SELECT: U3.36 (GPIO24); also elsewhere on the board
/ButtonsHaptics/BTNS.UP: U3.35 (GPIO23); also elsewhere on the board
/DbgResets/RP2040_RST: U3.26 (RUN); also elsewhere on the board
/LCD/LCD.B0: U3.13 (GPIO10); also elsewhere on the board
/LCD/LCD.B1: U3.16 (GPIO13); also elsewhere on the board
/LCD/LCD.BCK: U3.7 (GPIO5); also elsewhere on the board
/LCD/LCD.BSP: U3.9 (GPIO7); also elsewhere on the board
/LCD/LCD.G0: U3.12 (GPIO9); also elsewhere on the board
/LCD/LCD.G1: U3.15 (GPIO12); also elsewhere on the board
/LCD/LCD.GCK: U3.5 (GPIO3); also elsewhere on the board
/LCD/LCD.GEN: U3.8 (GPIO6); also elsewhere on the board
/LCD/LCD.GSP: U3.6 (GPIO4); also elsewhere on the board
/LCD/LCD.INTB: U3.4 (GPIO2); also elsewhere on the board
/LCD/LCD.R0: U3.11 (GPIO8); also elsewhere on the board
/LCD/LCD.R1: U3.14 (GPIO11); also elsewhere on the board
/LCD/LCD.VA: U3.17 (GPIO14); also elsewhere on the board
/LCD/LCD.VB: U3.18 (GPIO15); also elsewhere on the board
/Power/BL_CTRL/IO1: U3.29 (GPIO18); also elsewhere on the board
/Power/USB_DN: R9.2; also elsewhere on the board
/Power/USB_DP: R10.2; also elsewhere on the board
/RP2040/DBG_UART_RX: J5.1, U3.3 (GPIO1)
/RP2040/DBG_UART_TX: J5.2, U3.2 (GPIO0)
/RP2040/DVDD: C19.2, C20.2, J4.2, U3.23 (DVDD), U3.50 (DVDD)
/RP2040/INT_SENSORS: U3.30 (GPIO19); also elsewhere on the board
/RP2040/RP_SWCLK: J3.1, U3.24 (SWCLK)
/RP2040/RP_SWDIO: J3.2, U3.25 (SWD)
/RP2040/SCL_SENSORS: U3.28 (GPIO17); also elsewhere on the board
/RP2040/SDA_SENSORS: U3.27 (GPIO16); also elsewhere on the board
/RP2040/SPIFlash/CLK: U3.52 (QSPI_SCLK); also elsewhere on the board
/RP2040/SPIFlash/IO0: U3.53 (QSPI_SD0); also elsewhere on the board
/RP2040/SPIFlash/IO1: U3.55 (QSPI_SD1); also elsewhere on the board
/RP2040/SPIFlash/IO2: U3.54 (QSPI_SD2); also elsewhere on the board
/RP2040/SPIFlash/IO3: U3.51 (QSPI_SD3); also elsewhere on the board
/RP2040/SPIFlash/~CS: R7.2, U3.56 (QSPI_SS); also elsewhere on the board
/RP2040/USB_TERM_DN: R9.1, U3.46 (USB_DM)
/RP2040/USB_TERM_DP: R10.1, U3.47 (USB_DP)
GND: C17.1, C18.1, C19.1, C20.1, C21.2, C22.2, C23.2, C24.2, C25.2, C26.2, C27.2, C28.2, C29.2, J3.3, J5.3, SW1.1, U3.19 (TESTEN), U3.57 (GND); also elsewhere on the board
unnamed: C18.2, R8.1, Y1.2
unnamed: D3.2 (A), U3.34 (GPIO22)
unnamed: J4.3, U3.45 (VREG_VOUT)
unnamed: R7.1, SW1.2
unnamed: C17.2, U3.20 (XIN), Y1.1
unnamed: R8.2, U3.21 (XOUT)

Notes on the sheet:
decoupling for IOVDD
RP2040 SWD (1.8v)
445C25D12M00000
RP2040 DEBUG UART (1.8v)
DVDD select (1v1 or VREG_OUT)
BOOTSEL SELECT

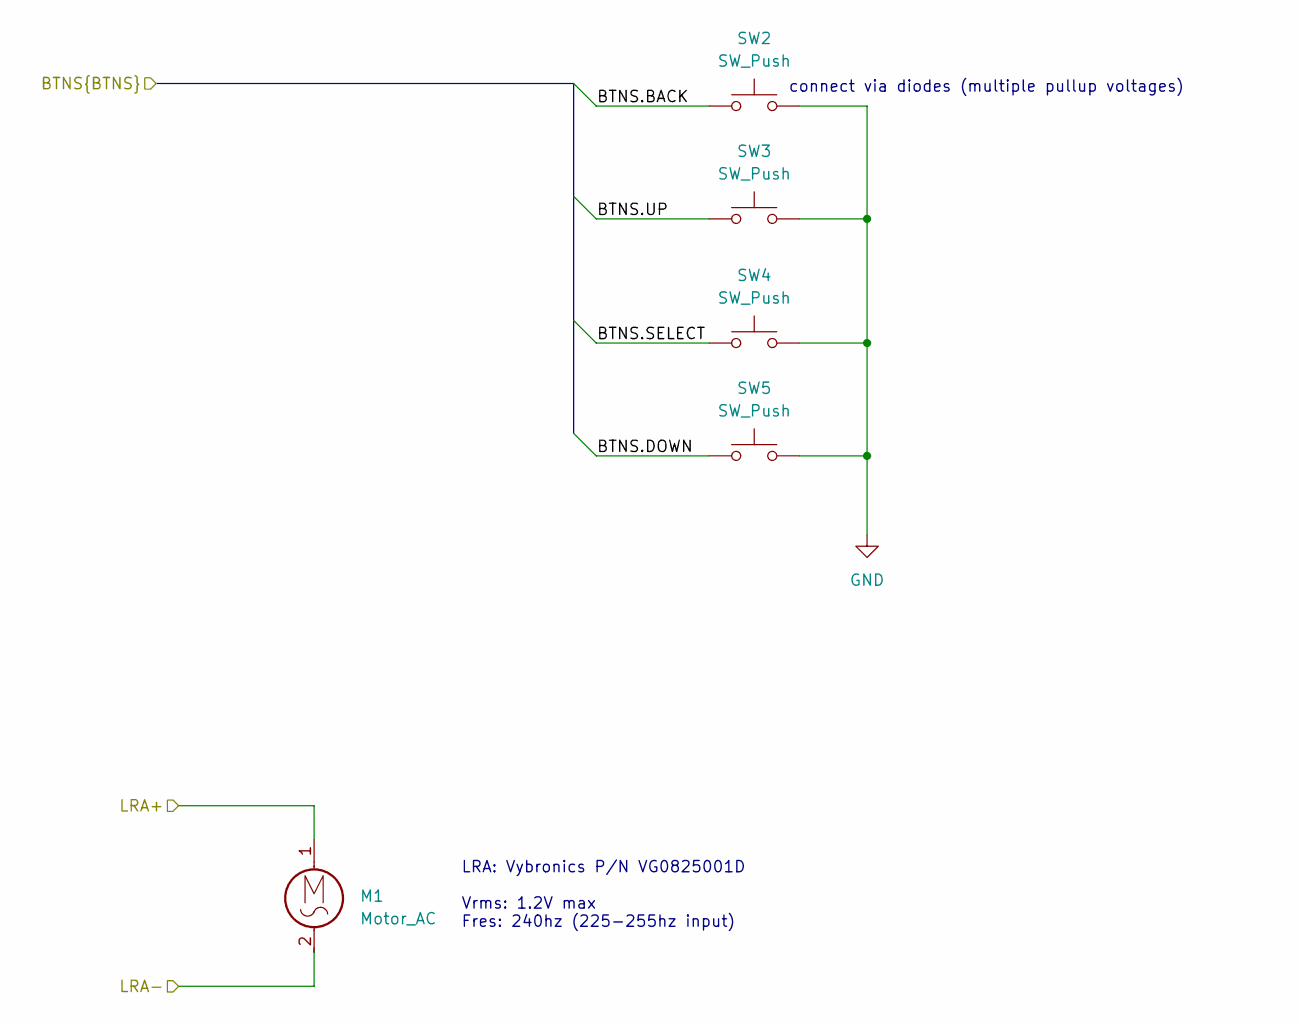
[picture p20: schematic buttons.kicad_sch, Buttons & Haptics]

Parts:
M1: Motor_AC; TerminalBlock_TE_282834-2_1x02_P2.54mm_Horizontal
SW2, SW3, SW4, SW5: SW_Push; SW_PUSH_6mm; MPN B3F-1020

Connections:
/ButtonsHaptics/BTNS.BACK: SW2.1; also elsewhere on the board
/ButtonsHaptics/BTNS.DOWN: SW5.1; also elsewhere on the board
/ButtonsHaptics/BTNS.SELECT: SW4.1; also elsewhere on the board
/ButtonsHaptics/BTNS.UP: SW3.1; also elsewhere on the board
/ButtonsHaptics/LRA+: M1.1; also elsewhere on the board
/ButtonsHaptics/LRA-: M1.2; also elsewhere on the board
GND: SW2.2, SW3.2, SW4.2, SW5.2; also elsewhere on the board

Notes on the sheet:
connect via diodes (multiple pullup voltages)
LRA: Vybronics P/N VG0825001D Vrms: 1.2V max Fres: 240hz (225-255hz input)

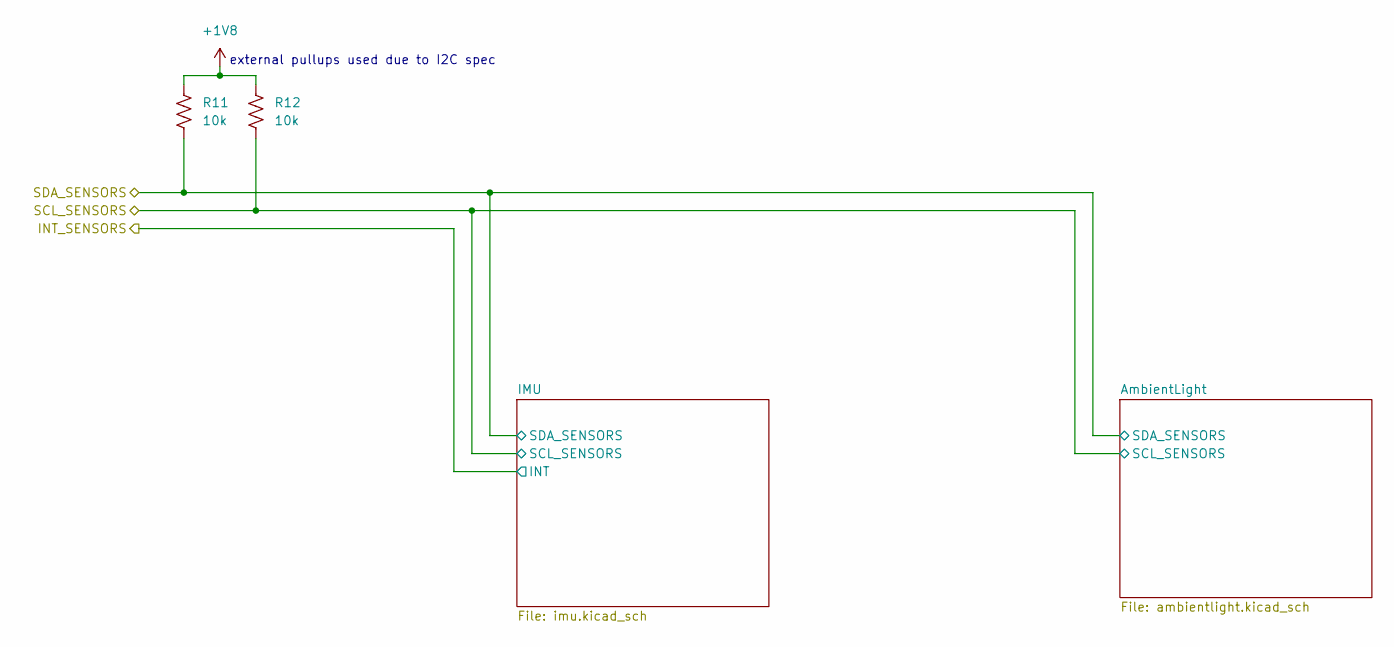
[picture p21: schematic sensors.kicad_sch, Sensor Bus]

Parts:
R11, R12: 10k; R_0201_0603Metric; MPN RC0201FR-0710KL

Connections:
+1V8: R11.1, R12.1; also elsewhere on the board
/RP2040/SCL_SENSORS: R12.2; also elsewhere on the board
/RP2040/SDA_SENSORS: R11.2; also elsewhere on the board

Notes on the sheet:
external pullups used due to I2C spec

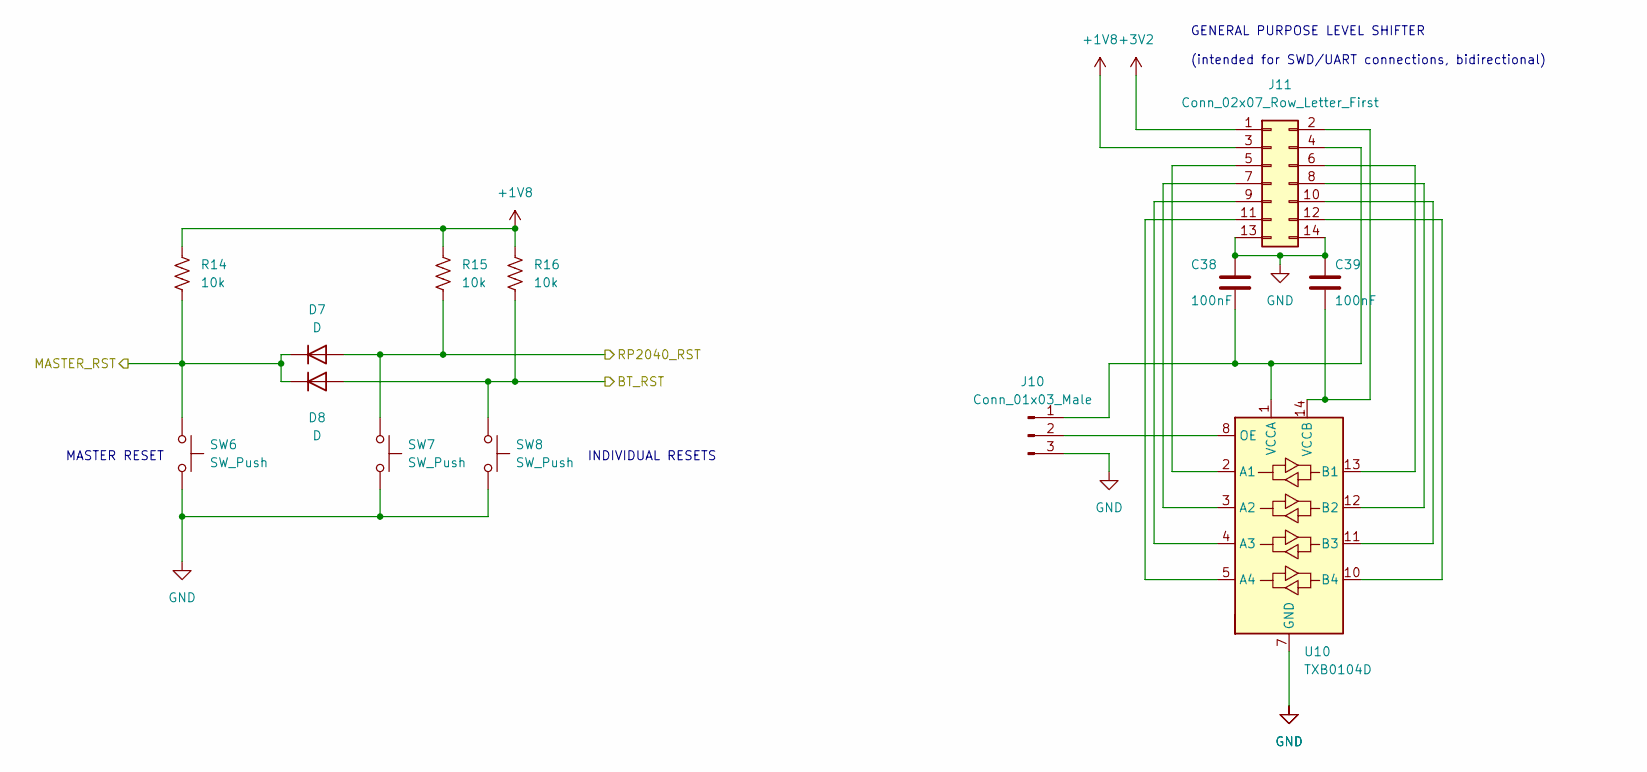
[picture p22: schematic resets.kicad_sch, Debug (Resets & Voltage Shifter)]

Parts:
C38, C39: 100nF; C_0201_0603Metric; MPN CC0201KRX5R8BB104
D7, D8: D; D_SOD-323; MPN CUS10S30,H3F
J10: Conn_01x03_Male; PinHeader_1x03_P2.54mm_Vertical
J11: Conn_02x07_Row_Letter_First; PinHeader_2x07_P2.54mm_Vertical
R14, R15, R16: 10k; R_0201_0603Metric; MPN RC0201FR-0710KL
SW6, SW7, SW8: SW_Push; SW_PUSH_6mm; MPN B3F-1020
U10: TXB0104D; SOIC-14_3.9x8.7mm_P1.27mm; MPN TXB0104D

Connections:
+1V8: J11.3, R14.1, R15.1, R16.1; also elsewhere on the board
+3V2: J11.1; also elsewhere on the board
/BT/RST: D8.2 (A), R16.2, SW8.1; also elsewhere on the board
/DbgResets/MASTER_RST: D7.1 (K), D8.1 (K), R14.2, SW6.1; also elsewhere on the board
/DbgResets/RP2040_RST: D7.2 (A), R15.2, SW7.1; also elsewhere on the board
GND: C38.1, C39.1, J10.3, J11.13, J11.14, SW6.2, SW7.2, SW8.2, U10.7 (GND); also elsewhere on the board
unnamed: C38.2, J10.1, J11.4, U10.1 (VCCA)
unnamed: J10.2, U10.8 (OE)
unnamed: C39.2, J11.2, U10.14 (VCCB)
unnamed: J11.5, U10.2 (A1)
unnamed: J11.6, U10.13 (B1)
unnamed: J11.7, U10.3 (A2)
unnamed: J11.8, U10.12 (B2)
unnamed: J11.9, U10.4 (A3)
unnamed: J11.10, U10.11 (B3)
unnamed: J11.11, U10.5 (A4)
unnamed: J11.12, U10.10 (B4)

Notes on the sheet:
INDIVIDUAL RESETS
MASTER RESET
GENERAL PURPOSE LEVEL SHIFTER (intended for SWD/UART connections, bidirectional)

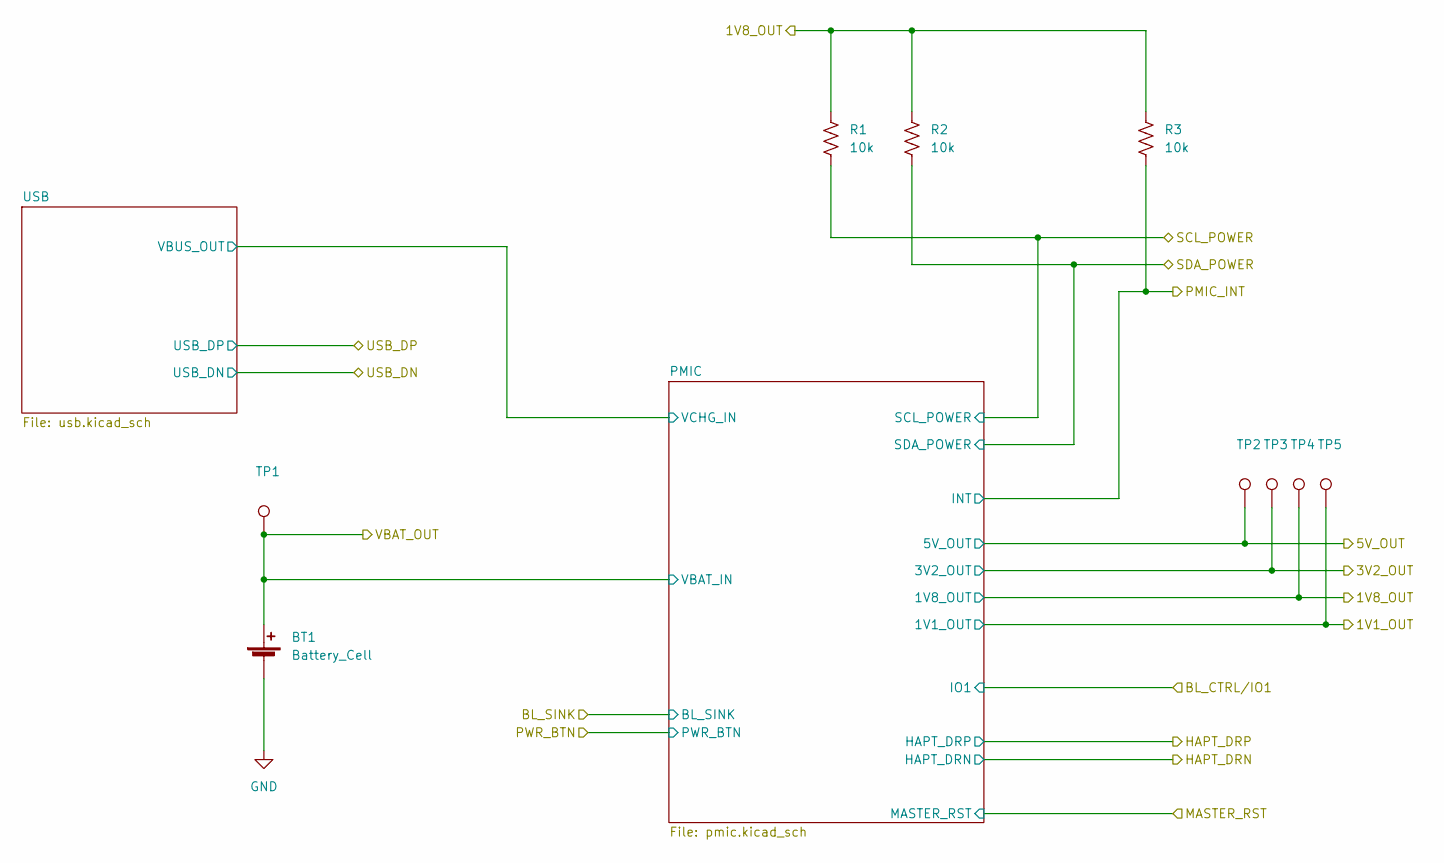
[picture p23: schematic powerman.kicad_sch, Power Path]

Parts:
BT1: Battery_Cell; JST_PH_B3B-PH-K_1x03_P2.00mm_Vertical; MPN B3B-PH-K-S(LF)(SN)
R1, R2, R3: 10k; R_0201_0603Metric; MPN RC0201FR-0710KL
TP1, TP2, TP3, TP4, TP5: TestPoint; TestPoint_Pad_D2.5mm

Connections:
+1V1: TP5.1; also elsewhere on the board
+1V8: R1.1, R2.1, R3.1, TP4.1; also elsewhere on the board
+3V2: TP3.1; also elsewhere on the board
+5V: TP2.1; also elsewhere on the board
+BATT: BT1.1 (+), TP1.1; also elsewhere on the board
/BT/PMIC_INT: R3.2; also elsewhere on the board
/BT/SCL_POWER: R1.2; also elsewhere on the board
/BT/SDA_POWER: R2.2; also elsewhere on the board
GND: BT1.2 (-); also elsewhere on the board

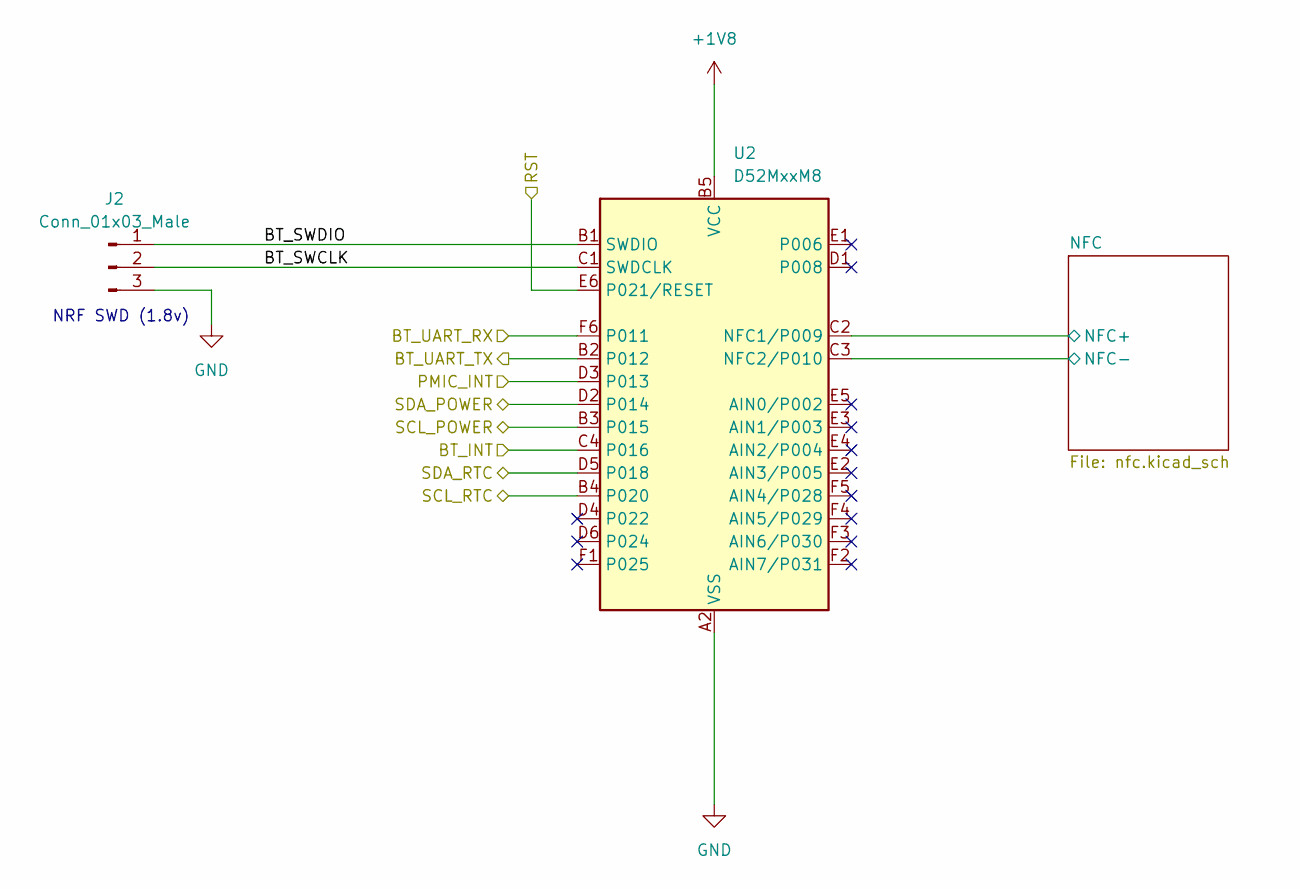
[picture p24: schematic bluetooth.kicad_sch, Bluetooth Controller]

Parts:
J2: Conn_01x03_Male; PinHeader_1x03_P2.54mm_Vertical
U2: D52MxxM8; Garmin_M8-35_9.8x14.0mm_Layout6x6_P1.5mm; MPN D52MD2M8IA-TRAY

Connections:
+1V8: U2.B5 (VCC), U2.B6 (VCC), U2.C5 (VCC), U2.C6 (VCC); also elsewhere on the board
/BT/BT_INT: U2.C4 (P016); also elsewhere on the board
/BT/BT_SWCLK: J2.2, U2.C1 (SWDCLK)
/BT/BT_SWDIO: J2.1, U2.B1 (SWDIO)
/BT/BT_UART_RX: U2.F6 (P011); also elsewhere on the board
/BT/BT_UART_TX: U2.B2 (P012); also elsewhere on the board
/BT/NFC/NFC+: U2.C2 (NFC1/P009); also elsewhere on the board
/BT/NFC/NFC-: U2.C3 (NFC2/P010); also elsewhere on the board
/BT/PMIC_INT: U2.D3 (P013); also elsewhere on the board
/BT/RST: U2.E6 (P021/RESET); also elsewhere on the board
/BT/SCL_POWER: U2.B3 (P015); also elsewhere on the board
/BT/SCL_RTC: U2.B4 (P020); also elsewhere on the board
/BT/SDA_POWER: U2.D2 (P014); also elsewhere on the board
/BT/SDA_RTC: U2.D5 (P018); also elsewhere on the board
GND: J2.3, U2.A2 (VSS), U2.A3 (VSS), U2.A4 (VSS), U2.A5 (VSS), U2.A6 (VSS); also elsewhere on the board

Notes on the sheet:
NRF SWD (1.8v)

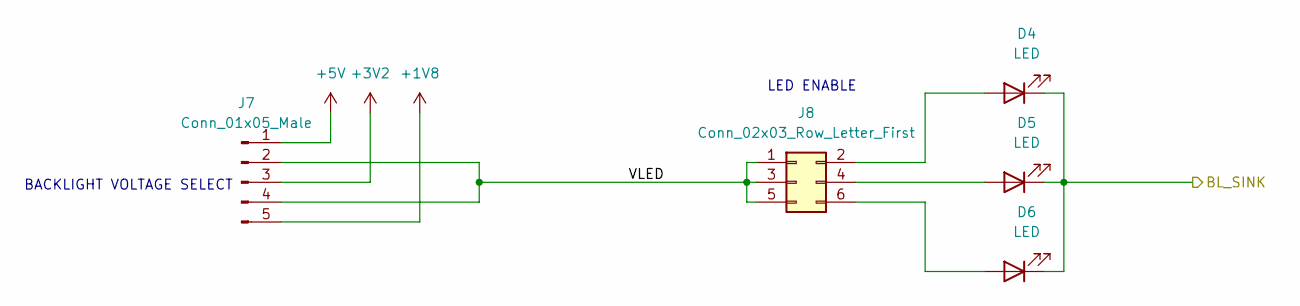
[picture p25: schematic lcdbl.kicad_sch, LCD Backlight]

Parts:
D4, D5, D6: LED; LED_0603_1608Metric; MPN BZ-C0603-C2-E1
J7: Conn_01x05_Male; PinHeader_1x05_P2.54mm_Vertical
J8: Conn_02x03_Row_Letter_First; PinHeader_2x03_P2.54mm_Vertical

Connections:
+1V8: J7.5; also elsewhere on the board
+3V2: J7.3; also elsewhere on the board
+5V: J7.1; also elsewhere on the board
/LCD/BL_SINK: D4.1 (K), D5.1 (K), D6.1 (K); also elsewhere on the board
/LCD/Backlight/VLED: J7.2, J7.4, J8.1, J8.3, J8.5
unnamed: D4.2 (A), J8.2
unnamed: D5.2 (A), J8.4
unnamed: D6.2 (A), J8.6

Notes on the sheet:
LED ENABLE
BACKLIGHT VOLTAGE SELECT

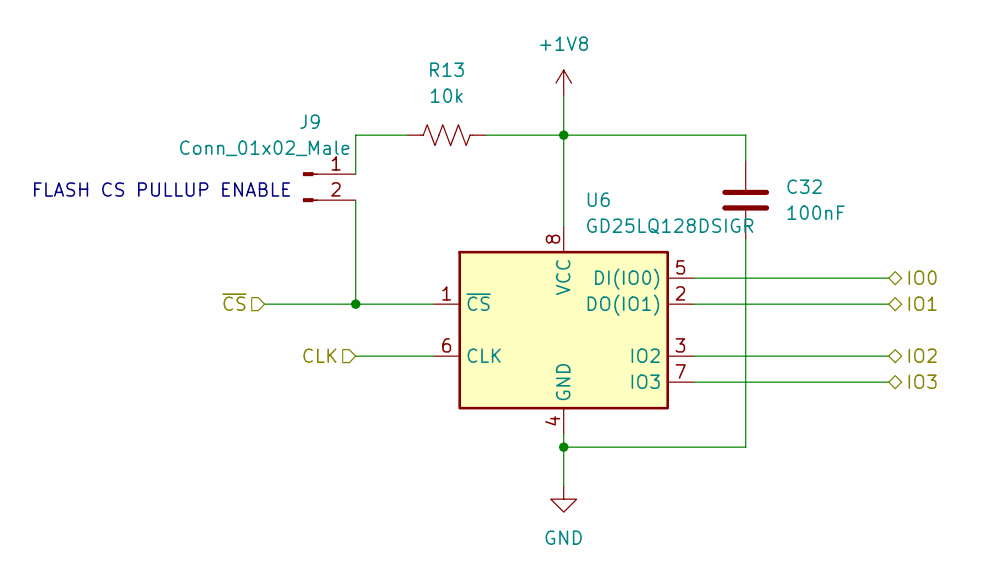
[picture p26: schematic spiflash.kicad_sch, Main CPU SPI Flash]

Parts:
C32: 100nF; C_0201_0603Metric; MPN CC0201KRX5R8BB104
J9: Conn_01x02_Male; PinHeader_1x02_P2.54mm_Vertical
R13: 10k; R_0201_0603Metric; MPN RC0201FR-0710KL
U6: GD25LQ128DSIGR; SOIC-8_5.23x5.23mm_P1.27mm; MPN GD25LQ128DSIGR

Connections:
+1V8: C32.1, R13.2, U6.8 (VCC); also elsewhere on the board
/RP2040/SPIFlash/CLK: U6.6 (CLK); also elsewhere on the board
/RP2040/SPIFlash/IO0: U6.5 (DI(IO0)); also elsewhere on the board
/RP2040/SPIFlash/IO1: U6.2 (DO(IO1)); also elsewhere on the board
/RP2040/SPIFlash/IO2: U6.3 (IO2); also elsewhere on the board
/RP2040/SPIFlash/IO3: U6.7 (IO3); also elsewhere on the board
/RP2040/SPIFlash/~CS: J9.2, U6.1 (~CS); also elsewhere on the board
GND: C32.2, U6.4 (GND); also elsewhere on the board
unnamed: J9.1, R13.1

Notes on the sheet:
FLASH CS PULLUP ENABLE

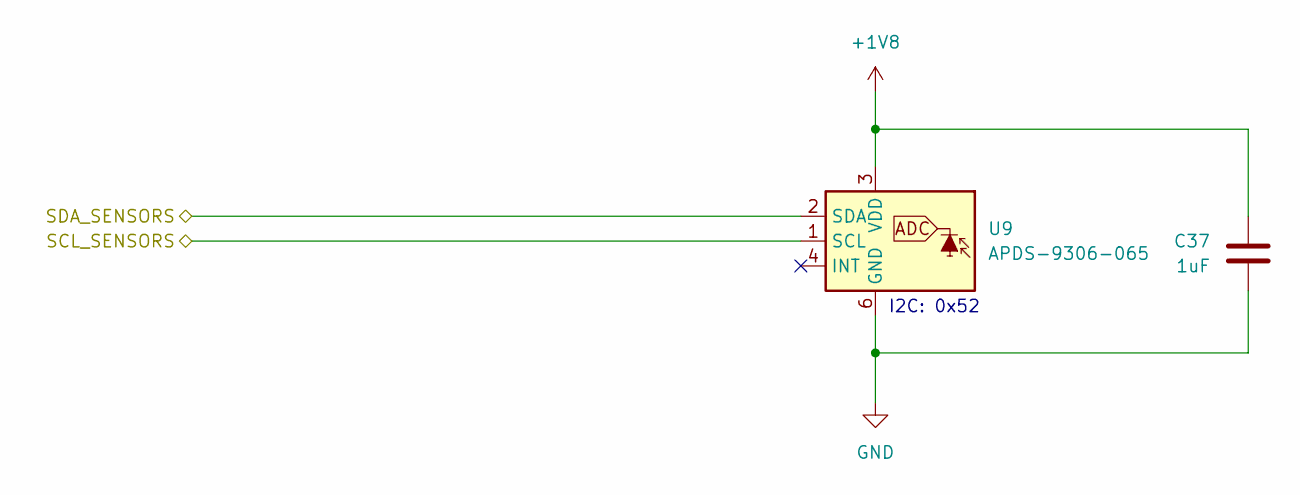
[picture p27: schematic ambientlight.kicad_sch, Ambient Light]

Parts:
C37: 1uF; C_0201_0603Metric; MPN CC0201MRX5R6BB105
U9: APDS-9306-065; Broadcom_DFN-6_2x2mm_P0.65mm; MPN APDS-9306-065

Connections:
+1V8: C37.1, U9.3 (VDD); also elsewhere on the board
/RP2040/SCL_SENSORS: U9.1 (SCL); also elsewhere on the board
/RP2040/SDA_SENSORS: U9.2 (SDA); also elsewhere on the board
GND: C37.2, U9.6 (GND); also elsewhere on the board

Notes on the sheet:
I2C: 0x52

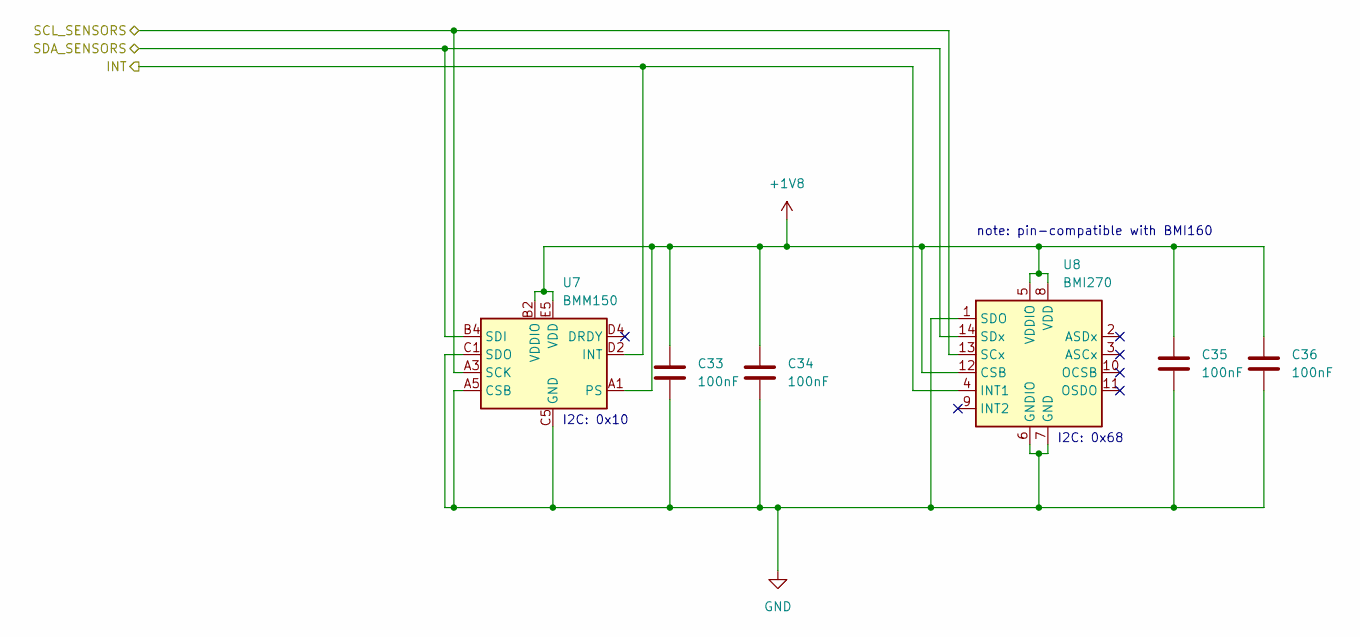
[picture p28: schematic imu.kicad_sch, IMU & Compass]

Parts:
C33, C34, C35, C36: 100nF; C_0201_0603Metric; MPN CC0201KRX5R8BB104
U7: BMM150; WLCSP-12_1.56x1.56mm_P0.4mm; MPN BMM150
U8: BMI270; Bosch_LGA-14_3x2.5mm_P0.5mm; MPN BMI270

Connections:
+1V8: C33.1, C34.1, C35.1, C36.1, U7.A1 (PS), U7.B2 (VDDIO), U7.E5 (VDD), U8.5 (VDDIO), U8.8 (VDD), U8.12 (CSB); also elsewhere on the board
/RP2040/INT_SENSORS: U7.D2 (INT), U8.4 (INT1); also elsewhere on the board
/RP2040/SCL_SENSORS: U7.A3 (SCK), U8.13 (SCx); also elsewhere on the board
/RP2040/SDA_SENSORS: U7.B4 (SDI), U8.14 (SDx); also elsewhere on the board
GND: C33.2, C34.2, C35.2, C36.2, U7.A5 (CSB), U7.C1 (SDO), U7.C5 (GND), U7.E1 (GND), U7.E3 (GND), U8.1 (SDO), U8.6 (GNDIO), U8.7 (GND); also elsewhere on the board

Notes on the sheet:
I2C: 0x10
note: pin-compatible with BMI160
I2C: 0x68

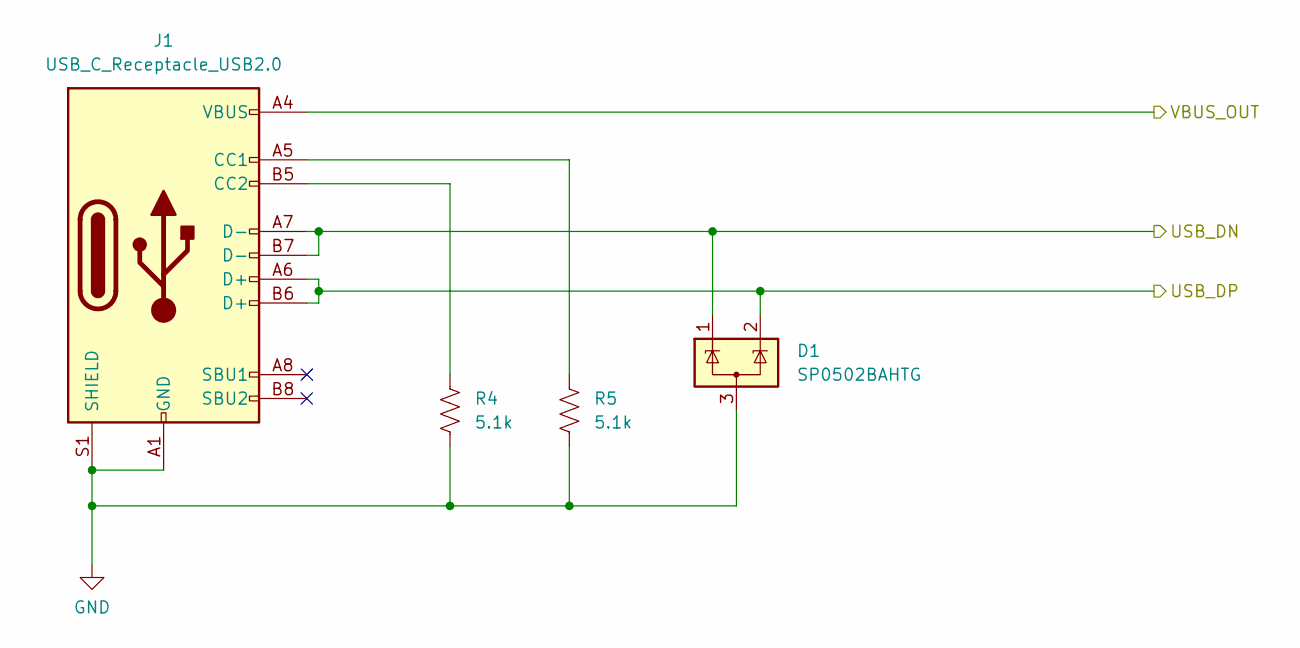
[picture p29: schematic usb.kicad_sch, USB Port]

Parts:
D1: SP0502BAHTG; SOT-23; MPN SP0502BAHTG
J1: USB_C_Receptacle_USB2.0; USB_C_Receptacle_XKB_U262-16XN-4BVC11; MPN U262-161N-4BVC11
R4, R5: 5.1k; R_0201_0603Metric; MPN RC0201FR-075K1L

Connections:
/Power/PMIC/VCHG_IN: J1.A4 (VBUS), J1.A9 (VBUS), J1.B4 (VBUS), J1.B9 (VBUS); also elsewhere on the board
/Power/USB_DN: D1.1 (K), J1.A7 (D-), J1.B7 (D-); also elsewhere on the board
/Power/USB_DP: D1.2 (K), J1.A6 (D+), J1.B6 (D+); also elsewhere on the board
GND: D1.3 (A), J1.A1 (GND), J1.A12 (GND), J1.B1 (GND), J1.B12 (GND), J1.S1 (SHIELD), R4.2, R5.2; also elsewhere on the board
unnamed: J1.A5 (CC1), R5.1
unnamed: J1.B5 (CC2), R4.1
