mincrmatt12/MWatch/board/bigboard/bigboard.kicad_pcb

## KiCad design board/bigboard/bigboard.kicad_pcb (continued)

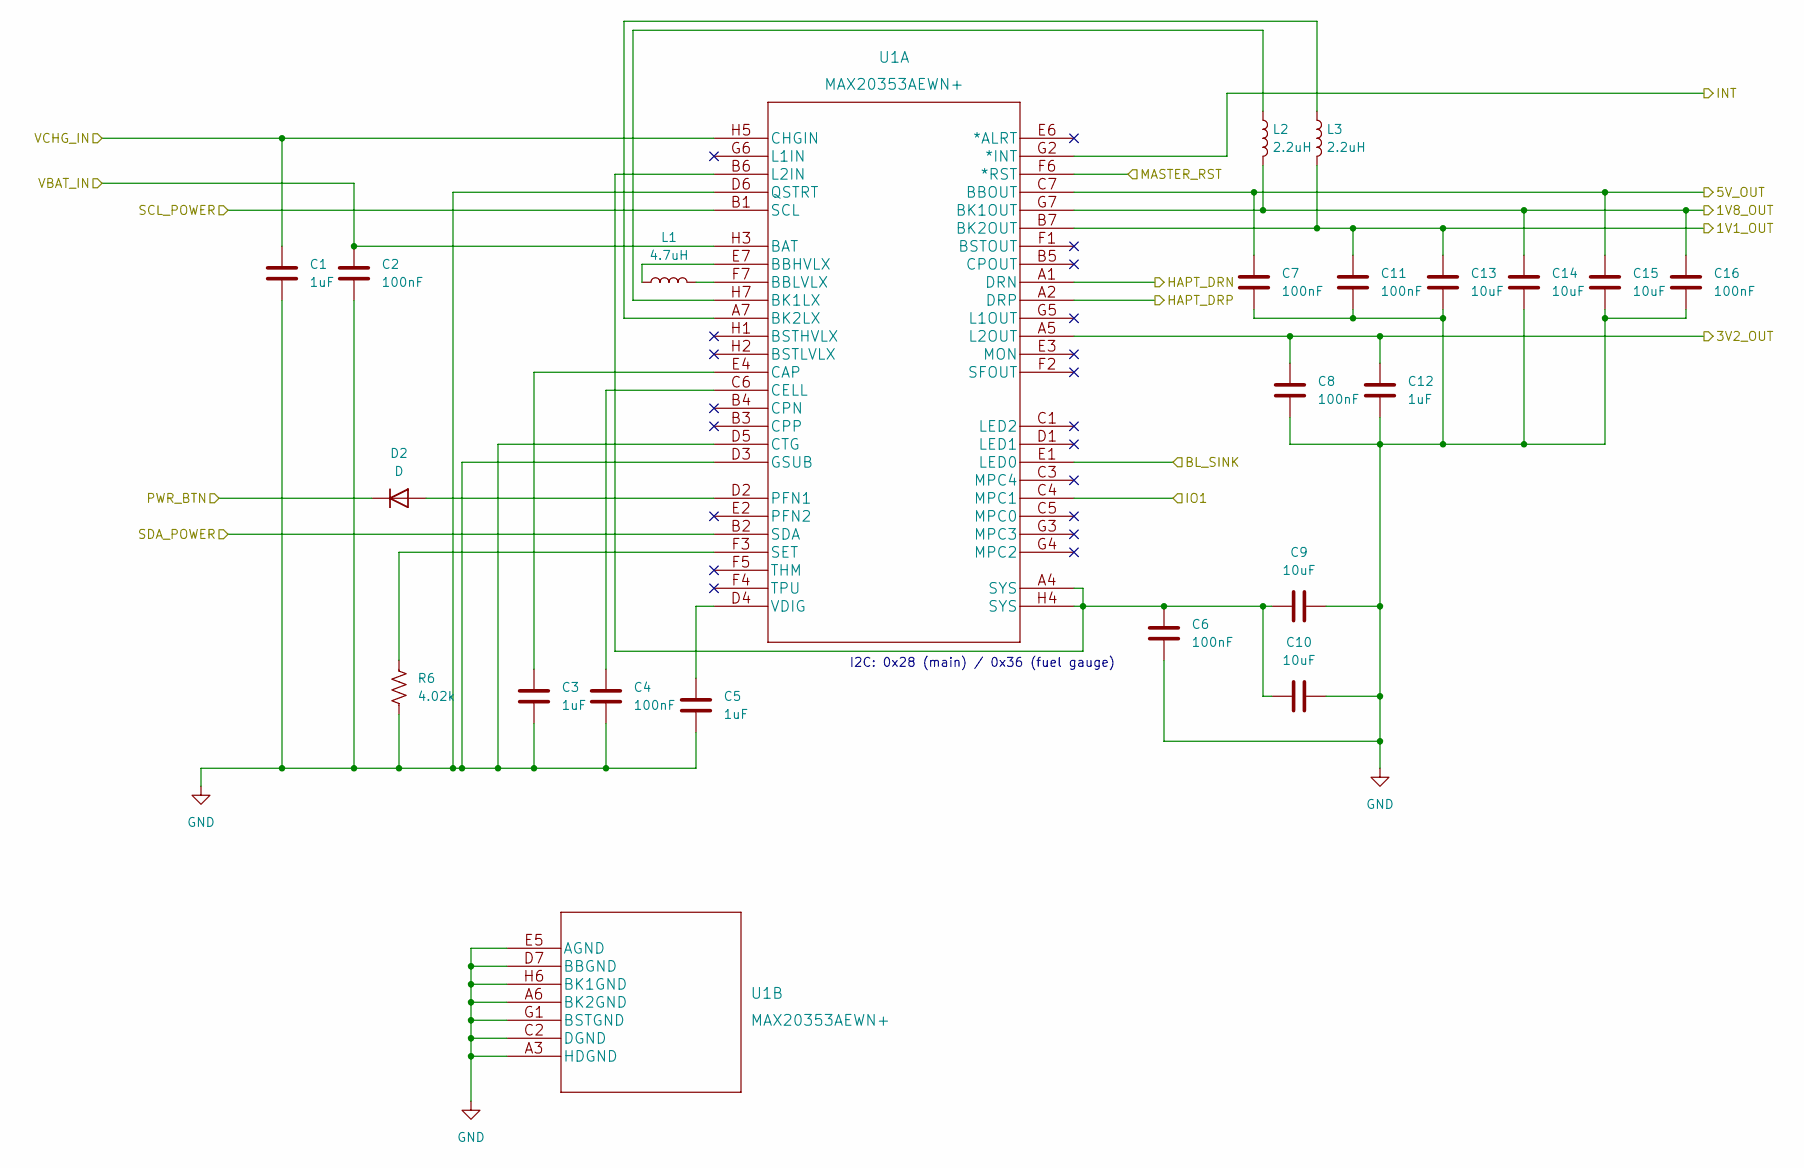
[picture p30: schematic pmic.kicad_sch]

Parts:
C1: 1uF; C_0603_1608Metric; MPN CC0603KRX5R7BB105
C2, C4, C6, C7, C8, C11, C16: 100nF; C_0201_0603Metric; MPN CC0201KRX5R8BB104
C3, C5, C12: 1uF; C_0201_0603Metric; MPN CC0201MRX5R6BB105
C9, C10, C13, C14, C15: 10uF; C_0603_1608Metric; MPN GRM188R61E106KA73D
D2: D; D_SOD-323; MPN CUS10S30,H3F
L1: 4.7uH; L_0805_2012Metric; MPN MLP2012V4R7MT0S1
L2, L3: 2.2uH; L_0805_2012Metric; MPN DFE201210U-2R2M=P2
R6: 4.02k; R_0201_0603Metric; MPN RC0201FR-074K02L
U1: MAX20353AEWN+; MAX20353AEWN&plus_; MPN MAX20353AEWN+

Connections:
+1V1: C11.1, C13.1, L3.2, U1.B7 (BK2OUT); also elsewhere on the board
+1V8: C14.1, C16.1, L2.2, U1.G7 (BK1OUT); also elsewhere on the board
+3V2: C8.1, C12.1, U1.A5 (L2OUT); also elsewhere on the board
+5V: C7.1, C15.1, U1.C7 (BBOUT); also elsewhere on the board
+BATT: C2.1, U1.H3 (BAT); also elsewhere on the board
/BT/PMIC_INT: U1.G2 (*INT); also elsewhere on the board
/BT/SCL_POWER: U1.B1 (SCL); also elsewhere on the board
/BT/SDA_POWER: U1.B2 (SDA); also elsewhere on the board
/ButtonsHaptics/BTNS.BACK: D2.1 (K); also elsewhere on the board
/ButtonsHaptics/LRA+: U1.A2 (DRP); also elsewhere on the board
/ButtonsHaptics/LRA-: U1.A1 (DRN); also elsewhere on the board
/DbgResets/MASTER_RST: U1.F6 (*RST); also elsewhere on the board
/LCD/BL_SINK: U1.E1 (LED0); also elsewhere on the board
/Power/BL_CTRL/IO1: U1.C4 (MPC1); also elsewhere on the board
/Power/PMIC/VCHG_IN: C1.1, U1.H5 (CHGIN); also elsewhere on the board
GND: C1.2, C2.2, C3.2, C4.2, C5.2, C6.2, C7.2, C8.2, C9.2, C10.2, C11.2, C12.2, C13.2, C14.2, C15.2, C16.2, R6.1, U1.A3 (HDGND), U1.A6 (BK2GND), U1.C2 (DGND), U1.D3 (GSUB), U1.D5 (CTG), U1.D6 (QSTRT), U1.D7 (BBGND), U1.E5 (AGND), U1.G1 (BSTGND), U1.H6 (BK1GND); also elsewhere on the board
unnamed: D2.2 (A), U1.D2 (PFN1)
unnamed: L1.1, U1.E7 (BBHVLX)
unnamed: L1.2, U1.F7 (BBLVLX)
unnamed: L2.1, U1.H7 (BK1LX)
unnamed: L3.1, U1.A7 (BK2LX)
unnamed: C3.1, U1.E4 (CAP)
unnamed: C4.1, U1.C6 (CELL)
unnamed: C6.1, C9.1, C10.1, U1.A4 (SYS), U1.B6 (L2IN), U1.H4 (SYS)
unnamed: R6.2, U1.F3 (SET)
unnamed: C5.1, U1.D4 (VDIG)

Notes on the sheet:
I2C: 0x28 (main) / 0x36 (fuel gauge)

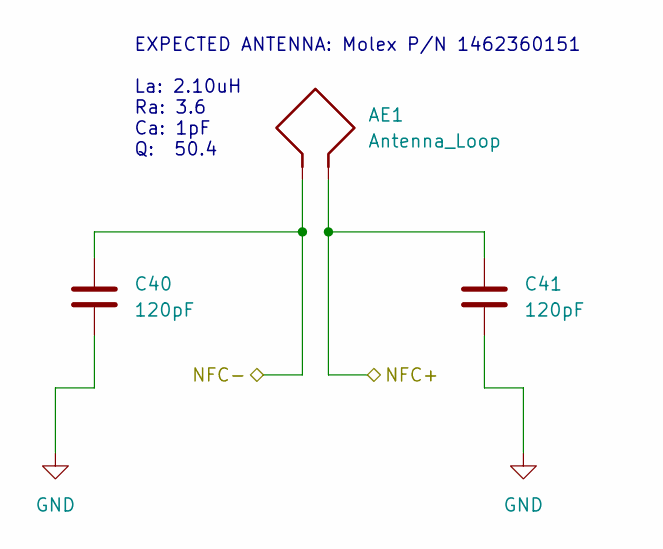
[picture p31: schematic nfc.kicad_sch, NFC Antenna]

Parts:
AE1: Antenna_Loop; TerminalBlock_TE_282834-2_1x02_P2.54mm_Horizontal
C40, C41: 120pF; C_0201_0603Metric; MPN GRM0335C1H121JA01J

Connections:
/BT/NFC/NFC+: AE1.2, C41.1; also elsewhere on the board
/BT/NFC/NFC-: AE1.1, C40.1; also elsewhere on the board
GND: C40.2, C41.2; also elsewhere on the board

Notes on the sheet:
EXPECTED ANTENNA: Molex P/N 1462360151 La: 2.10uH Ra: 3.6 Ca: 1pF Q: 50.4

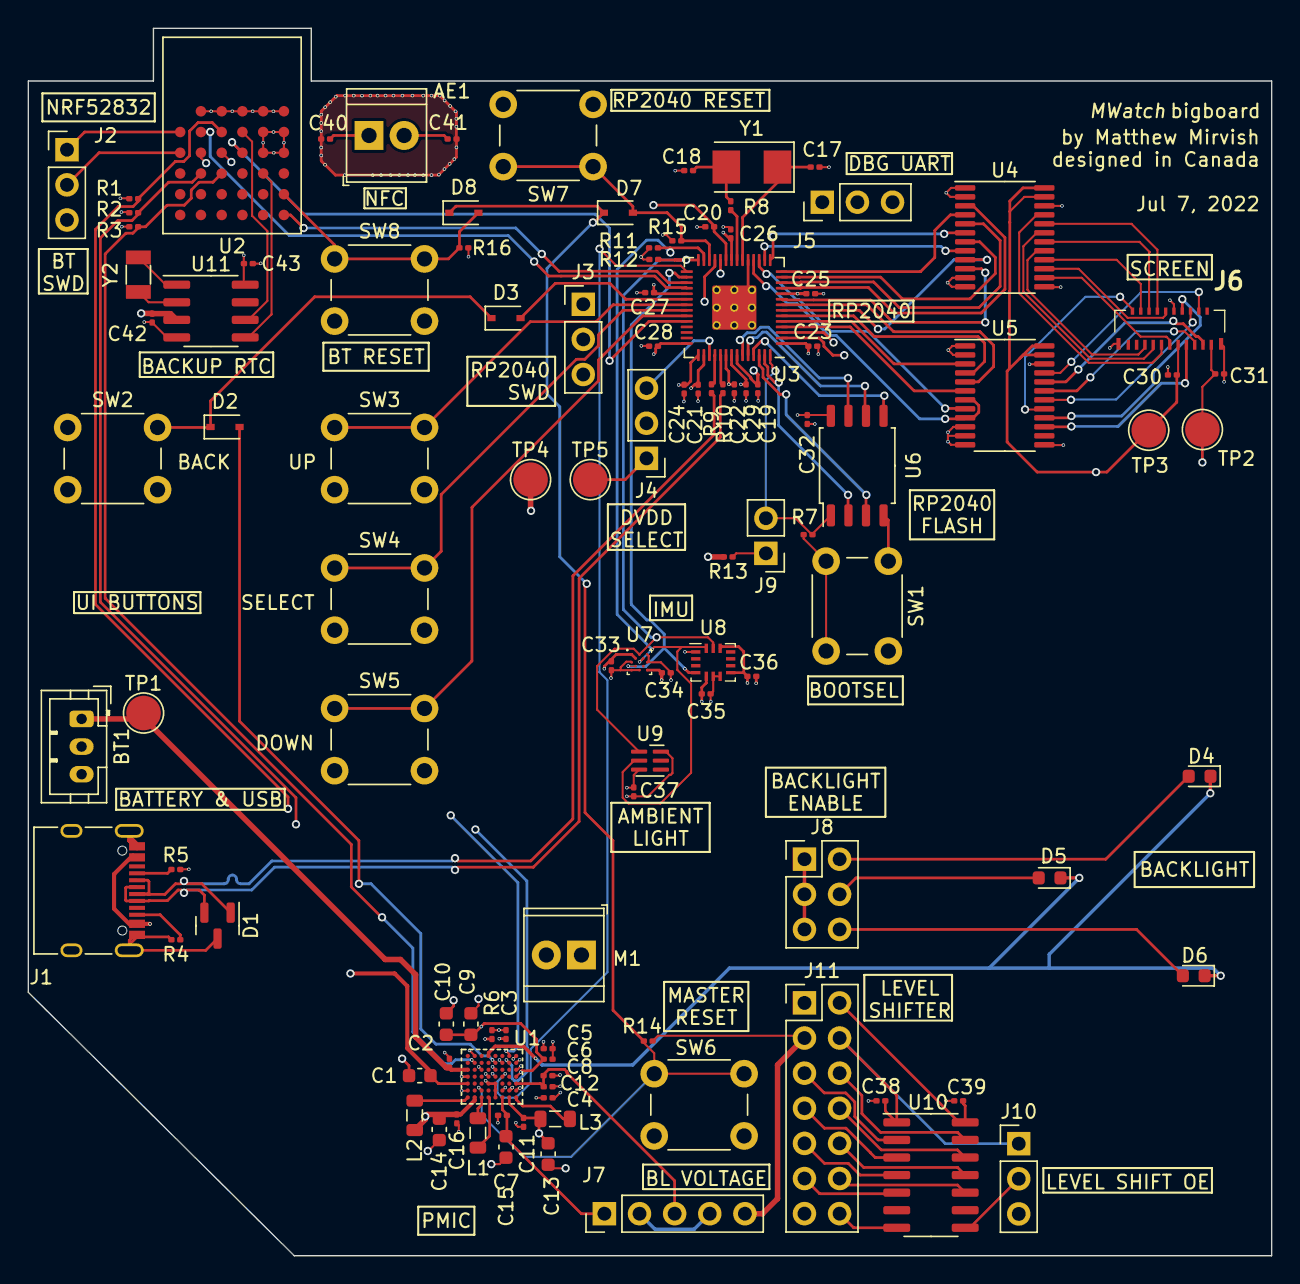
[picture p32: board bigboard.kicad_pcb from above]

Board: 4 copper layers, 89.9 x 88.8 mm, 110 parts (0 on the bottom side), 113 nets.
