mincrmatt12/MWatch/(commit log)

2022-07-07 Original board rev with wireless charge
    [ambientlight.kicad_sch, bigboard.kicad_pcb, bigboard.kicad_sch, bluetooth.kicad_sch, bom.ods, buttons.kicad_sch, imu.kicad_sch, lcd.kicad_sch]
2022-07-10 Manufactured version of bigboard
    [ambientlight.kicad_sch, bigboard.kicad_pcb, bigboard.kicad_sch, bluetooth.kicad_sch, buttons.kicad_sch, imu.kicad_sch, lcd.kicad_sch, lcdbl.kicad_sch]
2023-08-29 kernel: ecf: use alternative mechanism for allocation-failure tolerance
    uses fake coroutine frames stored in flash instead of error results.
    In the future, some sort of "error-invariance" trait should be put onto
    the underlying results so that a layout-compatible imposter for the
    result can be used to avoid making unnecessary duplicate constants.
    [main.cpp]
2023-09-08 Begin migrating RP2040 to picolibc w/o picosdk
    still uses the sdk for the hardware_* libs but with carefully selected
    files to avoid bringing too much of it in
    for example, all of the multicore stuff is excluded so we can do it
    ourselves inside the scheduler
    [crt0.c, libcpp.cpp, main.cpp, screen.cpp, stdio.c]
2023-09-09 Finish porting basic screentester to mwk & migrate to ram dma ctrl buf
    No longer eats the entire 16kib flash cache while scanning out a frame
    [crt0.c, main.cpp, screen.cpp, screen.h]
2023-09-10 Add emulated symmetric transfer mode
    LLVM on armv6m (or anything without thumb-2) has no support for tail
    calls. This causes a few problems, including crashing the compiler when
    trying to use coroutines (fixable with a basic patch) to untenable stack
    overflows, which is what this addresses.
    [main.cpp]
2023-09-11 Fix screen output
    - dma double buffer was busted
    - adjust VCOM freq to avoid flicker
    [screen.cpp, screen.h]
2023-09-11 Set pads to 1.8V thresholds in crt0
2023-09-11 Dummy BT_INT==5V_EN test power setup
2023-10-31 Update board to kicad 7
    [ambientlight.kicad_sch, bigboard.kicad_pcb, bigboard.kicad_sch, bluetooth.kicad_sch, buttons.kicad_sch, imu.kicad_sch, lcd.kicad_sch, lcdbl.kicad_sch]
